bemcgarvey/RX12G/README.md

## RX12G  

Next generation of the RX12 receiver with built in gyro/stabilization  
Can be used with up to 3 DSMX satellite receivers or with any receiver that supports sBus output
(like the FrSky XSR or r-XSR receivers)  

Documentation will appear here once I complete it.
