bemcgarvey/RX12G/software/RX12GConfig/images/Gauge.png

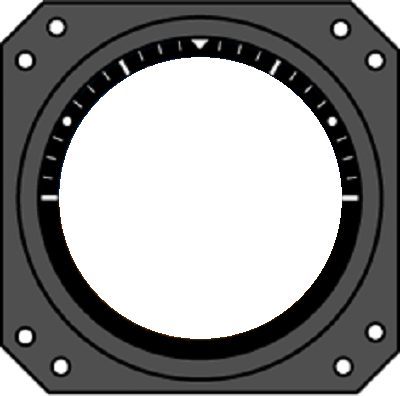
software/RX12GConfig/images/Gauge.png
