bemcgarvey/RX12G/schematic/RX12G.xlsx

RX12G BOM
Item | Qty | Reference(s) | Value | Footprint
1 | 9 | C1, C2, C3, C4, C5, C6, C7, C10, C11 | 100 nF | Capacitor_SMD:C_0402_1005Metric
2 | 1 | C8 | 10 uF | Capacitor_SMD:C_0603_1608Metric
3 | 1 | C9 | 2.2 uF | Capacitor_SMD:C_0603_1608Metric
4 | 5 | D1, D2, D3, D4, D6 | LED | LED_SMD:LED_0603_1608Metric
5 | 1 | D5 | MBR0520LT | Diode_SMD:D_SOD-123
6 | 1 | J1 | ICSP | Connector_PinHeader_2.54mm:PinHeader_1x05_P2.54mm_Vertical
7 | 3 | J2, J3, J4 | TSW-104-08-G-T-RA | SamacSys Parts:HDRRA12W64P254_3X4_1016X254X810P
8 | 3 | J5, J6, J8 | Conn_01x03 | JST_New:JST_ZH_B3B-ZR_1x03_P1.50mm_Vertical
9 | 1 | J7 | USB_B_Micro | Connector_USB:USB_Micro-B_Amphenol_10118194_Horizontal
10 | 1 | Q1 | 2N7002P_215 | digikey:SOT-23-3
11 | 4 | R1, R8, R10, R11 | 10k | Resistor_SMD:R_0603_1608Metric
12 | 4 | R2, R4, R5, R12 | 220R | Resistor_SMD:R_0603_1608Metric
13 | 1 | R3 | 62R | Resistor_SMD:R_0603_1608Metric
14 | 1 | R6 | 100k | Resistor_SMD:R_0603_1608Metric
15 | 1 | R7 | 1k | Resistor_SMD:R_0603_1608Metric
16 | 1 | R9 | 20k | Resistor_SMD:R_0603_1608Metric
17 | 1 | SW1 | SW_MEC_5E | SamacSys Parts:PTS647SK38SMTR2LFS
18 | 1 | U1 | PIC32MK1024GPK064-I/PT | PIC32MK:PIC32MK1024GPK064-I&slash_PT
19 | 1 | U2 | LSM6DSO32TR | IMU:LSM6DSO32TR
20 | 1 | U3 | AP2210N-3.3TRG1 | SamacSys Parts:SOT95P280X145-3N
21 | 1 | X1 | 24 MHz | SamacSys Parts:ASTMUPCE3312000MHZLJET
