bemcgarvey/RX12G/docs/ChangeLog.txt

RX12G Change log

Firmware:
	V1.0	Initial release
	V1.1	Fixed a bug in the bind routine
	V1.2	Added ExpressLRS (CRSF) receiver option
	
Software:
	V1.0	Initial release
	V1.2	Updated for ExpressLRS option (also changed to match firmware version.)
	
PCB:
	V1.0	Initial release
