bemcgarvey/RX12G/schematic/RX12G.kicad_pcb

## KiCad design schematic/RX12G.kicad_pcb (2025-07-03)

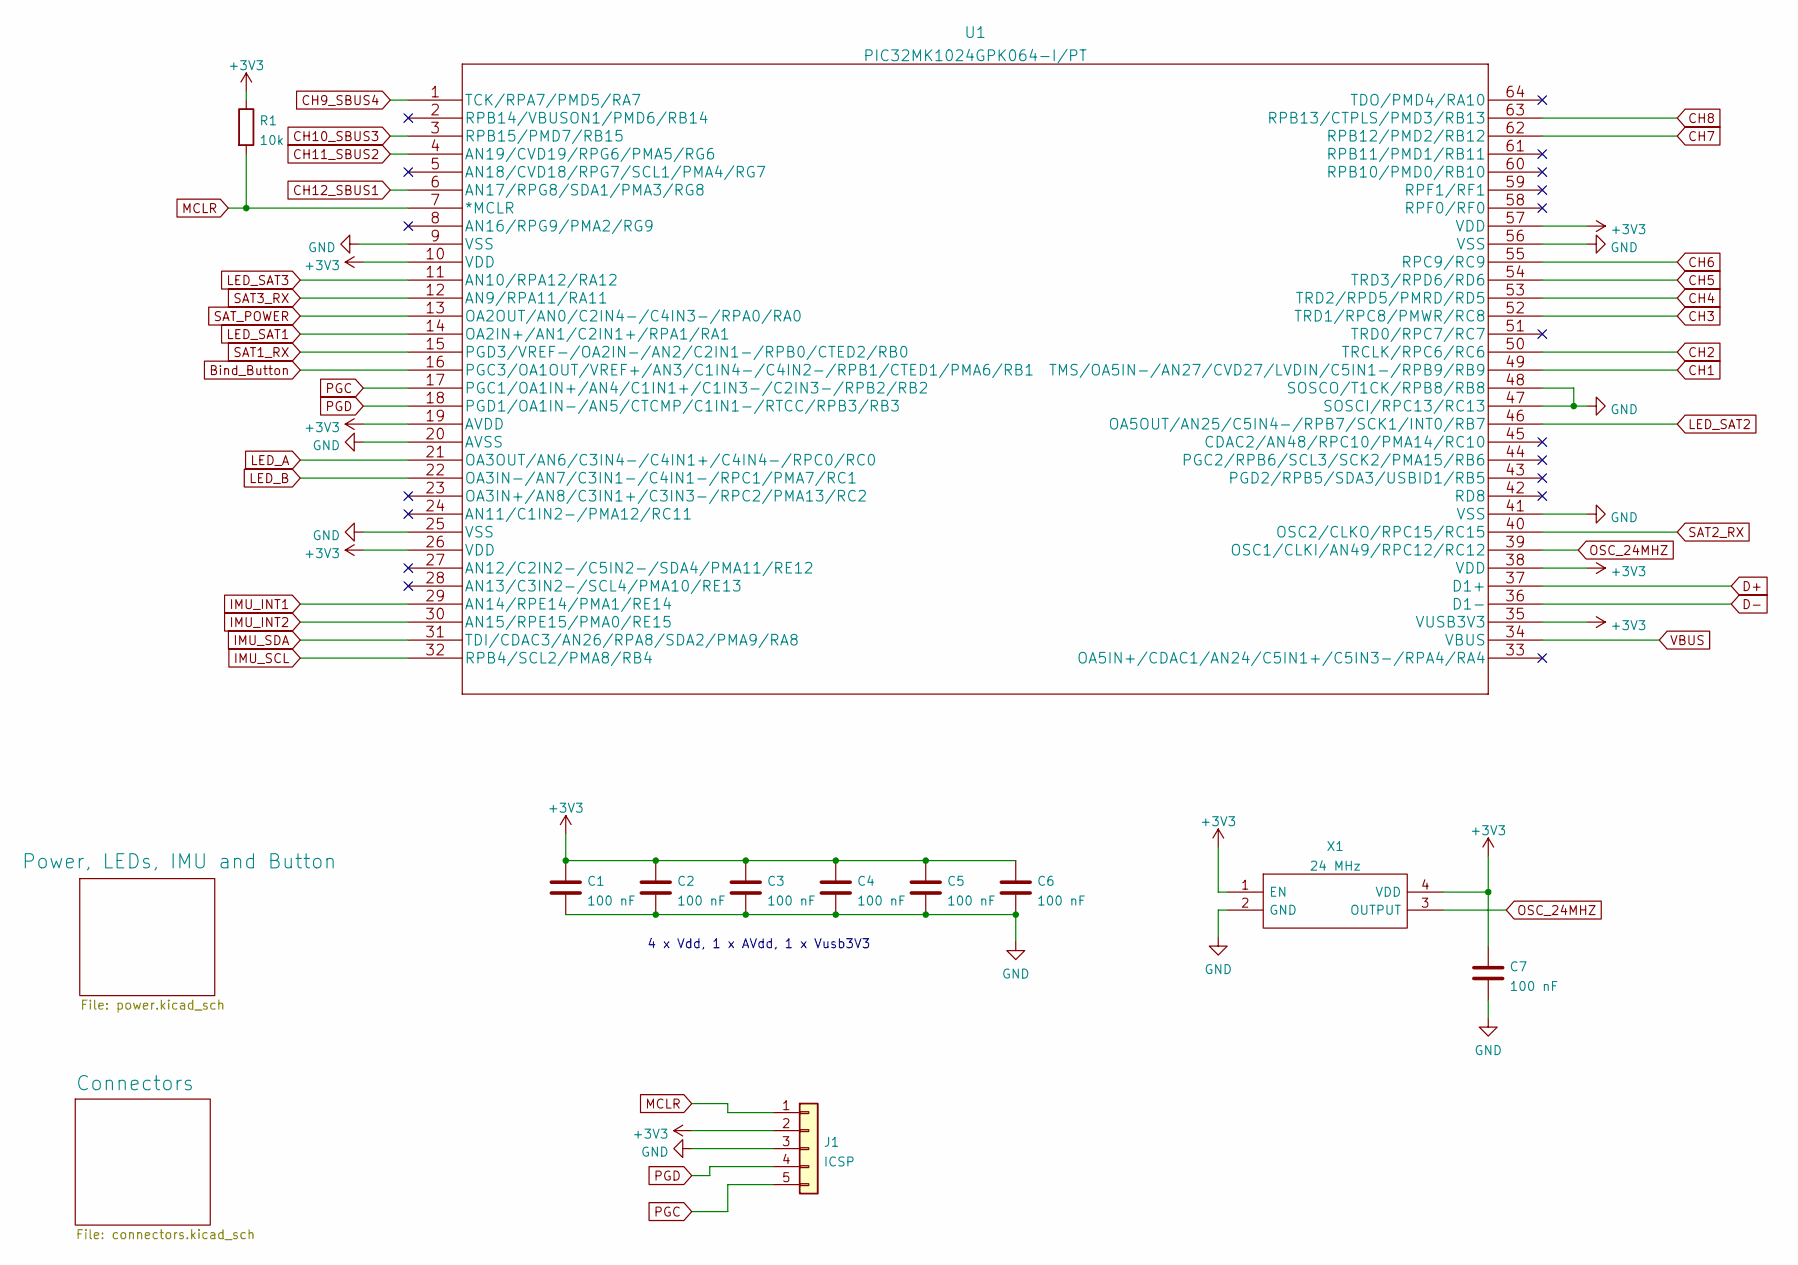
[picture p2: schematic RX12G.kicad_sch]

Parts:
C1, C2, C3, C4, C5, C6, C7: 100 nF; C_0402_1005Metric
J1: ICSP; PinHeader_1x05_P2.54mm_Vertical
R1: 10k; R_0603_1608Metric
U1: PIC32MK1024GPK064-I/PT; PIC32MK1024GPK064-I&slash_PT
X1: 24 MHz; ASTMUPCE3312000MHZLJET; Mouser Part Number 815-AMPMAFB-12.0000T

Connections:
+3V3: C1.1, C2.1, C3.1, C4.1, C5.1, C6.1, C7.1, J1.2, R1.1, U1.10 (VDD), U1.19 (AVDD), U1.26 (VDD), U1.35 (VUSB3V3), U1.38 (VDD), U1.57 (VDD), X1.1 (EN), X1.4 (VDD); also elsewhere on the board
Bind_Button: U1.16 (PGC3/OA1OUT/VREF+/AN3/C1IN4-/C4IN2-/RPB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); also elsewhere on the board
CH1: U1.49 (TMS/OA5IN-/AN27/CVD27/LVDIN/C5IN1-/RPB9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); also elsewhere on the board
CH2: U1.50 (TRCLK/RPC6/RC6); also elsewhere on the board
CH3: U1.52 (TRD1/RPC8/PMWR/RC8); also elsewhere on the board
CH4: U1.53 (TRD2/RPD5/PMRD/RD5); also elsewhere on the board
CH5: U1.54 (TRD3/RPD6/RD6); also elsewhere on the board
CH6: U1.55 (RPC9/RC9); also elsewhere on the board
CH7: U1.62 (RPB12/PMD2/RB12); also elsewhere on the board
CH8: U1.63 (RPB13/CTPLS/PMD3/RB13); also elsewhere on the board
CH9_SBUS4: U1.1 (TCK/RPA7/PMD5/RA7); also elsewhere on the board
CH10_SBUS3: U1.3 (RPB15/PMD7/RB15); also elsewhere on the board
CH11_SBUS2: U1.4 (AN19/CVD19/RPG6/PMA5/RG6); also elsewhere on the board
CH12_SBUS1: U1.6 (AN17/RPG8/SDA1/PMA3/RG8); also elsewhere on the board
D+: U1.37 (D1+); also elsewhere on the board
D-: U1.36 (D1-); also elsewhere on the board
GND: C1.2, C2.2, C3.2, C4.2, C5.2, C6.2, C7.2, J1.3, U1.9 (VSS), U1.20 (AVSS), U1.25 (VSS), U1.41 (VSS), U1.47 (SOSCI/RPC13/RC13), U1.48 (SOSCO/T1CK/RPB8/RB8), U1.56 (VSS), X1.2 (GND); also elsewhere on the board
IMU_INT1: U1.29 (AN14/RPE14/PMA1/RE14); also elsewhere on the board
IMU_INT2: U1.30 (AN15/RPE15/PMA0/RE15); also elsewhere on the board
IMU_SCL: U1.32 (RPB4/SCL2/PMA8/RB4); also elsewhere on the board
IMU_SDA: U1.31 (TDI/CDAC3/AN26/RPA8/SDA2/PMA9/RA8); also elsewhere on the board
LED_A: U1.21 (OA3OUT/AN6/C3IN4-/C4IN1+/C4IN4-/RPC0/RC0); also elsewhere on the board
LED_B: U1.22 (OA3IN-/AN7/C3IN1-/C4IN1-/RPC1/PMA7/RC1); also elsewhere on the board
LED_SAT1: U1.14 (OA2IN+/AN1/C2IN1+/RPA1/RA1); also elsewhere on the board
LED_SAT2: U1.46 (OA5OUT/AN25/C5IN4-/RPB7/SCK1/INT0/RB7); also elsewhere on the board
LED_SAT3: U1.11 (AN10/RPA12/RA12); also elsewhere on the board
MCLR: J1.1, R1.2, U1.7 (*MCLR)
OSC_24MHZ: U1.39 (OSC1/CLKI/AN49/RPC12/RC12), X1.3 (OUTPUT)
PGC: J1.5, U1.17 (PGC1/OA1IN+/AN4/C1IN1+/C1IN3-/C2IN3-/RP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)
PGD: J1.4, U1.18 (PGD1/OA1IN-/AN5/CTCMP/C1IN1-/RTCC/RPB3/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)
SAT1_RX: U1.15 (PGD3/VREF-/OA2IN-/AN2/C2IN1-/RPB0/CTED2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); also elsewhere on the board
SAT2_RX: U1.40 (OSC2/CLKO/RPC15/RC15); also elsewhere on the board
SAT3_RX: U1.12 (AN9/RPA11/RA11); also elsewhere on the board
SAT_POWER: U1.13 (OA2OUT/AN0/C2IN4-/C4IN3-/RPA0/RA0); also elsewhere on the board
VBUS: U1.34 (VBUS); also elsewhere on the board

Notes on the sheet:
4 x Vdd, 1 x AVdd, 1 x Vusb3V3

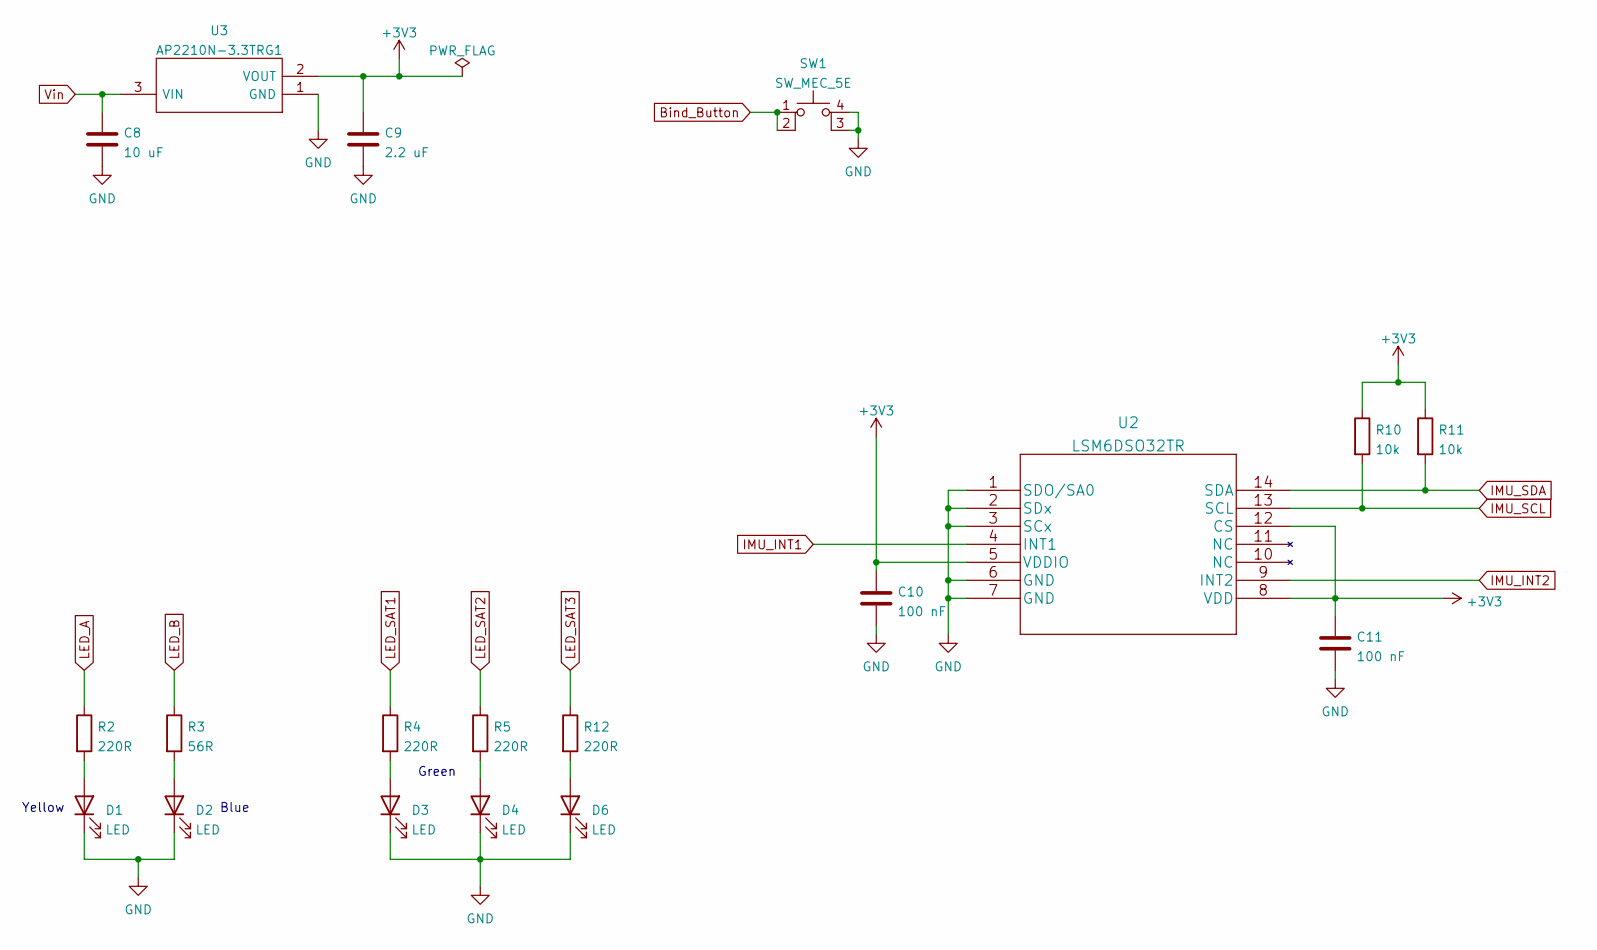
[picture p3: schematic power.kicad_sch, RX12G]

Parts:
C8: 10 uF; C_0603_1608Metric
C9: 2.2 uF; C_0603_1608Metric
C10, C11: 100 nF; C_0402_1005Metric
D1, D2, D3, D4, D6: LED; LED_0603_1608Metric
R2, R4, R5, R12: 220R; R_0603_1608Metric
R3: 56R; R_0603_1608Metric
R10, R11: 10k; R_0603_1608Metric
SW1: SW_MEC_5E; PTS647SK38SMTR2LFS
U2: LSM6DSO32TR
U3: AP2210N-3.3TRG1; SOT95P280X145-3N; Mouser Part Number 621-AP2210N-3.3TRG1

Connections:
+3V3: C9.1, C10.1, C11.1, R10.1, R11.1, U2.5 (VDDIO), U2.8 (VDD), U2.12 (CS), U3.2 (VOUT); also elsewhere on the board
Bind_Button: SW1.1, SW1.2; also elsewhere on the board
GND: C8.2, C9.2, C10.2, C11.2, D1.1 (K), D2.1 (K), D3.1 (K), D4.1 (K), D6.1 (K), SW1.3 (K), SW1.4 (A), U2.1 (SDO/SA0), U2.2 (SDx), U2.3 (SCx), U2.6 (GND), U2.7 (GND), U3.1 (GND); also elsewhere on the board
IMU_INT1: U2.4 (INT1); also elsewhere on the board
IMU_INT2: U2.9 (INT2); also elsewhere on the board
IMU_SCL: R10.2, U2.13 (SCL); also elsewhere on the board
IMU_SDA: R11.2, U2.14 (SDA); also elsewhere on the board
LED_A: R2.1; also elsewhere on the board
LED_B: R3.1; also elsewhere on the board
LED_SAT1: R4.1; also elsewhere on the board
LED_SAT2: R5.1; also elsewhere on the board
LED_SAT3: R12.1; also elsewhere on the board
unnamed: D1.2 (A), R2.2
unnamed: D2.2 (A), R3.2
unnamed: D3.2 (A), R4.2
unnamed: D4.2 (A), R5.2
unnamed: D6.2 (A), R12.2
Vin: C8.1, U3.3 (VIN); also elsewhere on the board

Notes on the sheet:
Blue
Yellow
Green

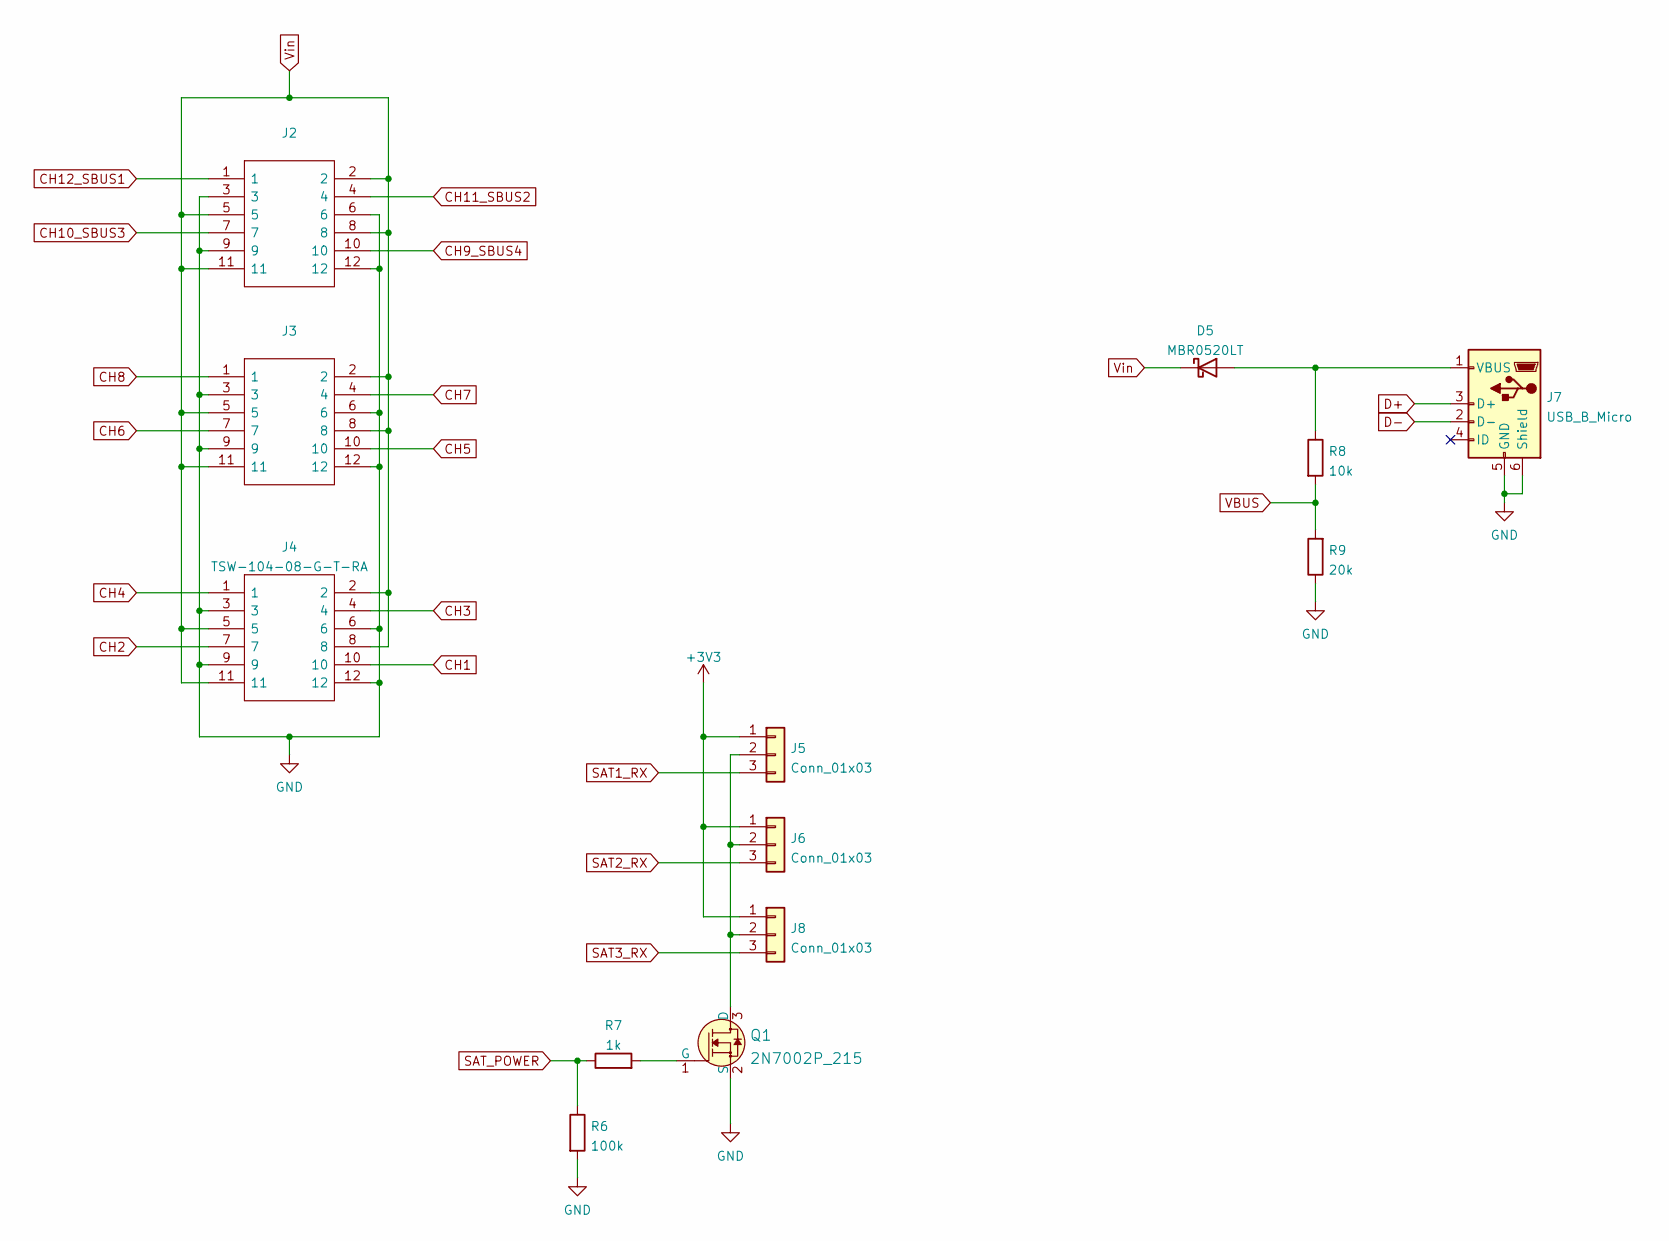
[picture p4: schematic connectors.kicad_sch, RX12G]

Parts:
D5: MBR0520LT; D_SOD-123
J2, J3, J4: TSW-104-08-G-T-RA; HDRRA12W64P254_3X4_1016X254X810P; Mouser Part Number 200-TSW10408GTRA
J5, J6, J8: Conn_01x03; JST_ZH_B3B-ZR_1x03_P1.50mm_Vertical
J7: USB_B_Micro; USB_Micro-B_Amphenol_10118194_Horizontal
Q1: 2N7002P_215; SOT-23-3; MPN 2N7002P,215; Digi-Key_PN 1727-4692-1-ND
R6: 100k; R_0603_1608Metric
R7: 1k; R_0603_1608Metric
R8: 10k; R_0603_1608Metric
R9: 20k; R_0603_1608Metric

Connections:
+3V3: J5.1, J6.1, J8.1; also elsewhere on the board
CH1: J4.10; also elsewhere on the board
CH2: J4.7; also elsewhere on the board
CH3: J4.4; also elsewhere on the board
CH4: J4.1; also elsewhere on the board
CH5: J3.10; also elsewhere on the board
CH6: J3.7; also elsewhere on the board
CH7: J3.4; also elsewhere on the board
CH8: J3.1; also elsewhere on the board
CH9_SBUS4: J2.10; also elsewhere on the board
CH10_SBUS3: J2.7; also elsewhere on the board
CH11_SBUS2: J2.4; also elsewhere on the board
CH12_SBUS1: J2.1; also elsewhere on the board
D+: J7.3 (D+); also elsewhere on the board
D-: J7.2 (D-); also elsewhere on the board
GND: J2.3, J2.6, J2.9, J2.12, J3.3, J3.6, J3.9, J3.12, J4.3, J4.6, J4.9, J4.12, J7.5 (GND), J7.6 (Shield), Q1.2 (S), R6.2, R9.1; also elsewhere on the board
unnamed: D5.2 (A), J7.1 (VBUS), R8.1
unnamed: J5.2, J6.2, J8.2, Q1.3 (D)
unnamed: Q1.1 (G), R7.2
SAT1_RX: J5.3; also elsewhere on the board
SAT2_RX: J6.3; also elsewhere on the board
SAT3_RX: J8.3; also elsewhere on the board
SAT_POWER: R6.1, R7.1; also elsewhere on the board
VBUS: R8.2, R9.2; also elsewhere on the board
Vin: D5.1 (K), J2.2, J2.5, J2.8, J2.11, J3.2, J3.5, J3.8, J3.11, J4.2, J4.5, J4.8, J4.11; also elsewhere on the board

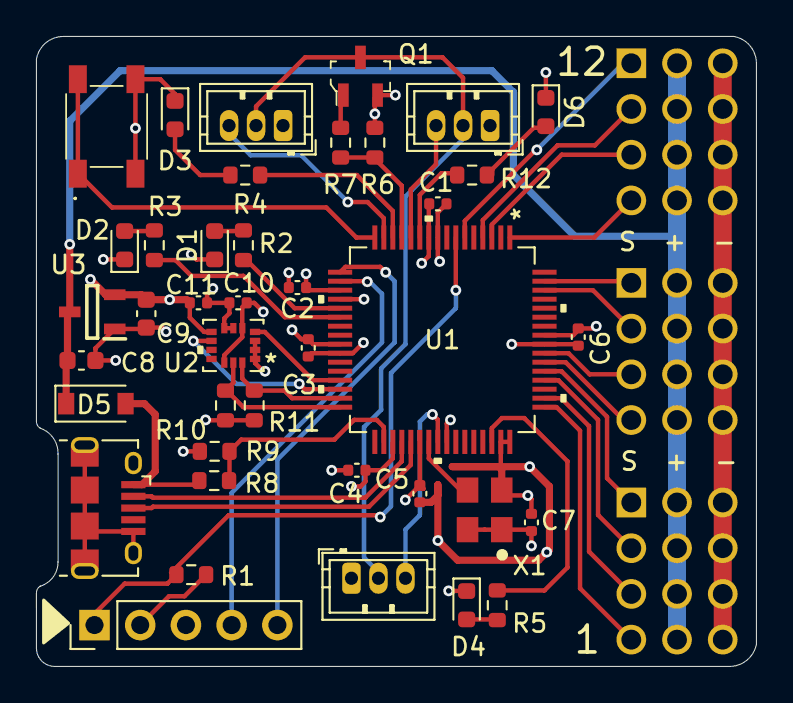
[picture p5: board RX12G.kicad_pcb from above]

Board: 4 copper layers, 40.0 x 35.0 mm, 43 parts (0 on the bottom side), 44 nets.
