bemcgarvey/RX12G/firmware/src/config/default/default.mhc/project.yml

files:
- generatedChecksum: F58DB2348A0FCE945652B285010E5F8A
  logicalPath: FreeRTOS/Source
  name: FreeRTOS_tasks.c
  physicalPath: ../../third_party/rtos/FreeRTOS/Source
  security: NON_SECURE
  type: SOURCE
  userChecksum: F58DB2348A0FCE945652B285010E5F8A
- generatedChecksum: 8ACE0DEBD82F6829438A4674565451FB
  logicalPath: FreeRTOS/Source
  name: croutine.c
  physicalPath: ../../third_party/rtos/FreeRTOS/Source
  security: NON_SECURE
  type: SOURCE
  userChecksum: 8ACE0DEBD82F6829438A4674565451FB
- generatedChecksum: DC797D8719875948452BA69E3CA29A20
  logicalPath: config/default/driver/usb/usbfs/src
  name: drv_usbfs.c
  physicalPath: driver/usb/usbfs/src
  security: NON_SECURE
  type: SOURCE
  userChecksum: DC797D8719875948452BA69E3CA29A20
- generatedChecksum: 77A61E825804B2CA96FC95734161DDE6
  logicalPath: config/default/driver/usb/usbfs/src
  name: drv_usbfs_device.c
  physicalPath: driver/usb/usbfs/src
  security: NON_SECURE
  type: SOURCE
  userChecksum: 77A61E825804B2CA96FC95734161DDE6
- generatedChecksum: B3B5445B14BD9B6A35F1C5B995C9BBF7
  logicalPath: FreeRTOS/Source
  name: event_groups.c
  physicalPath: ../../third_party/rtos/FreeRTOS/Source
  security: NON_SECURE
  type: SOURCE
  userChecksum: B3B5445B14BD9B6A35F1C5B995C9BBF7
- generatedChecksum: 4BBDE3B7B0DAEE2CA5A8F519001D5BFF
  logicalPath: config/default
  name: exceptions.c
  physicalPath: ''
  security: NON_SECURE
  type: SOURCE
  userChecksum: 4BBDE3B7B0DAEE2CA5A8F519001D5BFF
- generatedChecksum: B7DBFD6F500AAD4713403E985EB18EAE
  logicalPath: config/default
  name: freertos_hooks.c
  physicalPath: ''
  security: NON_SECURE
  type: SOURCE
  userChecksum: B7DBFD6F500AAD4713403E985EB18EAE
- generatedChecksum: 972E955D94A63BA89BF6ABD6AADB1023
  logicalPath: FreeRTOS/Source/portable/MemMang
  name: heap_1.c
  physicalPath: ../../third_party/rtos/FreeRTOS/Source/portable/MemMang
  security: NON_SECURE
  type: SOURCE
  userChecksum: 972E955D94A63BA89BF6ABD6AADB1023
- generatedChecksum: 48812D34B3555F392EFF538B2A6A2353
  logicalPath: config/default
  name: initialization.c
  physicalPath: ''
  security: NON_SECURE
  type: SOURCE
  userChecksum: 3A6EB55353075EAA23272D4A66DB0A16
- generatedChecksum: 384AE8E9396E7FE9A9E65B6F2B428288
  logicalPath: config/default
  name: interrupts.c
  physicalPath: ''
  security: NON_SECURE
  type: SOURCE
  userChecksum: 539F881B37D143FDCCB9A4367FEBEFB9
- generatedChecksum: 70F7AD626138E8BD00ED013EAD14C618
  logicalPath: config/default
  name: interrupts_a.S
  physicalPath: ''
  security: NON_SECURE
  type: SOURCE
  userChecksum: 70F7AD626138E8BD00ED013EAD14C618
- generatedChecksum: 3FEE521CEF14928AE38E7FA9BF6D75E6
  logicalPath: FreeRTOS/Source
  name: list.c
  physicalPath: ../../third_party/rtos/FreeRTOS/Source
  security: NON_SECURE
  type: SOURCE
  userChecksum: 3FEE521CEF14928AE38E7FA9BF6D75E6
- generatedChecksum: null
  logicalPath: ''
  name: main.c
  physicalPath: ../..
  security: NON_SECURE
  type: SOURCE
  userChecksum: null
- generatedChecksum: 8FDD6248506F28B32C4F5FD9AA0D9C6F
  logicalPath: config/default/osal
  name: osal_freertos.c
  physicalPath: osal
  security: NON_SECURE
  type: SOURCE
  userChecksum: 8FDD6248506F28B32C4F5FD9AA0D9C6F
- generatedChecksum: F5E41C2993989490F38B123FA11C9263
  logicalPath: config/default/peripheral/clk
  name: plib_clk.c
  physicalPath: peripheral/clk
  security: NON_SECURE
  type: SOURCE
  userChecksum: B8C42457976288F32E9F4C2873EB2320
- generatedChecksum: F8BB2BAA74068083A80E6E229BBCF3E3
  logicalPath: config/default/peripheral/coretimer
  name: plib_coretimer.c
  physicalPath: peripheral/coretimer
  security: NON_SECURE
  type: SOURCE
  userChecksum: F8BB2BAA74068083A80E6E229BBCF3E3
- generatedChecksum: 5BFD7C5599A1B32A969F2C09F13311BC
  logicalPath: config/default/peripheral/dmac
  name: plib_dmac.c
  physicalPath: peripheral/dmac
  security: NON_SECURE
  type: SOURCE
  userChecksum: 5BFD7C5599A1B32A969F2C09F13311BC
- generatedChecksum: F0F77E9605002F86303776FD504751EB
  logicalPath: config/default/peripheral/eeprom
  name: plib_eeprom.c
  physicalPath: peripheral/eeprom
  security: NON_SECURE
  type: SOURCE
  userChecksum: F0F77E9605002F86303776FD504751EB
- generatedChecksum: 086ECC21CDD1F409510ABE62F9ED852D
  logicalPath: config/default/peripheral/evic
  name: plib_evic.c
  physicalPath: peripheral/evic
  security: NON_SECURE
  type: SOURCE
  userChecksum: 086ECC21CDD1F409510ABE62F9ED852D
- generatedChecksum: 164C9CF0E8E5FC6CB108971E897BB18D
  logicalPath: config/default/peripheral/gpio
  name: plib_gpio.c
  physicalPath: peripheral/gpio
  security: NON_SECURE
  type: SOURCE
  userChecksum: 164C9CF0E8E5FC6CB108971E897BB18D
- generatedChecksum: 099E9B7B3808BD6A9ED5E3D0246DEDAD
  logicalPath: config/default/peripheral/i2c/master
  name: plib_i2c2_master.c
  physicalPath: peripheral/i2c/master
  security: NON_SECURE
  type: SOURCE
  userChecksum: 099E9B7B3808BD6A9ED5E3D0246DEDAD
- generatedChecksum: B5141F23FAB135F92A71071EEBDC3ED2
  logicalPath: config/default/peripheral/tmr
  name: plib_tmr2.c
  physicalPath: peripheral/tmr
  security: NON_SECURE
  type: SOURCE
  userChecksum: B5141F23FAB135F92A71071EEBDC3ED2
- generatedChecksum: 96370224FB0E16D2836D4CE9CF8AEFF5
  logicalPath: config/default/peripheral/tmr
  name: plib_tmr5.c
  physicalPath: peripheral/tmr
  security: NON_SECURE
  type: SOURCE
  userChecksum: 96370224FB0E16D2836D4CE9CF8AEFF5
- generatedChecksum: F503211688B80701FFC8E8C8F6A49DFC
  logicalPath: config/default/peripheral/tmr
  name: plib_tmr6.c
  physicalPath: peripheral/tmr
  security: NON_SECURE
  type: SOURCE
  userChecksum: F503211688B80701FFC8E8C8F6A49DFC
- generatedChecksum: B9579201B0CE4CA37E49E2B0B27DEAEF
  logicalPath: config/default/peripheral/tmr
  name: plib_tmr7.c
  physicalPath: peripheral/tmr
  security: NON_SECURE
  type: SOURCE
  userChecksum: B9579201B0CE4CA37E49E2B0B27DEAEF
- generatedChecksum: 057EEB6ABFE129F06B5EE43255777501
  logicalPath: config/default/peripheral/tmr
  name: plib_tmr8.c
  physicalPath: peripheral/tmr
  security: NON_SECURE
  type: SOURCE
  userChecksum: 057EEB6ABFE129F06B5EE43255777501
- generatedChecksum: 7B8D2E0DA556712DBC3DF51B76A57427
  logicalPath: config/default/peripheral/tmr
  name: plib_tmr9.c
  physicalPath: peripheral/tmr
  security: NON_SECURE
  type: SOURCE
  userChecksum: 7B8D2E0DA556712DBC3DF51B76A57427
- generatedChecksum: 3822D4C43CB11882404ECB2B28DD61EA
  logicalPath: config/default/driver/usb/usbfs/src
  name: plib_usbfs_header.h
  physicalPath: driver/usb/usbfs/src
  security: NON_SECURE
  type: SOURCE
  userChecksum: 3822D4C43CB11882404ECB2B28DD61EA
- generatedChecksum: D2B5BDC2F4578FDBBADED01931AF6259
  logicalPath: config/default/peripheral/wdt
  name: plib_wdt.c
  physicalPath: peripheral/wdt
  security: NON_SECURE
  type: SOURCE
  userChecksum: D2B5BDC2F4578FDBBADED01931AF6259
- generatedChecksum: 0E851159CFF7B40028D295108F0F7474
  logicalPath: FreeRTOS/Source/portable/MPLAB/PIC32MK
  name: port.c
  physicalPath: ../../third_party/rtos/FreeRTOS/Source/portable/MPLAB/PIC32MK
  security: NON_SECURE
  type: SOURCE
  userChecksum: 0E851159CFF7B40028D295108F0F7474
- generatedChecksum: 17FB1DE2D7DF3950AACC03B19F54459C
  logicalPath: FreeRTOS/Source/portable/MPLAB/PIC32MK
  name: port_asm.S
  physicalPath: ../../third_party/rtos/FreeRTOS/Source/portable/MPLAB/PIC32MK
  security: NON_SECURE
  type: SOURCE
  userChecksum: 17FB1DE2D7DF3950AACC03B19F54459C
- generatedChecksum: 09041728D74A4E3A32C7D4EAA96C4EE7
  logicalPath: FreeRTOS/Source
  name: queue.c
  physicalPath: ../../third_party/rtos/FreeRTOS/Source
  security: NON_SECURE
  type: SOURCE
  userChecksum: 09041728D74A4E3A32C7D4EAA96C4EE7
- generatedChecksum: D6CF30BDCE1A813D9ACF3905EBD6A871
  logicalPath: FreeRTOS/Source
  name: stream_buffer.c
  physicalPath: ../../third_party/rtos/FreeRTOS/Source
  security: NON_SECURE
  type: SOURCE
  userChecksum: D6CF30BDCE1A813D9ACF3905EBD6A871
- generatedChecksum: C95CE0ABB86E6B11CF77E8891D294510
  logicalPath: config/default/system/int
  name: sys_int.c
  physicalPath: system/int/src
  security: NON_SECURE
  type: SOURCE
  userChecksum: C95CE0ABB86E6B11CF77E8891D294510
- generatedChecksum: 47B584985982B2FF32628D4CB874CB4D
  logicalPath: config/default/system/reset
  name: sys_reset.c
  physicalPath: system/reset
  security: NON_SECURE
  type: SOURCE
  userChecksum: 47B584985982B2FF32628D4CB874CB4D
- generatedChecksum: 9A24475E3F58E7FE0B22FBA7B0A412A3
  logicalPath: config/default
  name: tasks.c
  physicalPath: ''
  security: NON_SECURE
  type: SOURCE
  userChecksum: 9A24475E3F58E7FE0B22FBA7B0A412A3
- generatedChecksum: F1B86F6E1527FD59A8713B67564F2898
  logicalPath: FreeRTOS/Source
  name: timers.c
  physicalPath: ../../third_party/rtos/FreeRTOS/Source
  security: NON_SECURE
  type: SOURCE
  userChecksum: F1B86F6E1527FD59A8713B67564F2898
- generatedChecksum: BCCEF5B801FFD0CF22D0B454D2F25F1F
  logicalPath: config/default/usb/src
  name: usb_device.c
  physicalPath: usb/src
  security: NON_SECURE
  type: SOURCE
  userChecksum: BCCEF5B801FFD0CF22D0B454D2F25F1F
- generatedChecksum: B8D87B6533E2CE239E9EEB8486DF6996
  logicalPath: config/default/usb/src
  name: usb_device_hid.c
  physicalPath: usb/src
  security: NON_SECURE
  type: SOURCE
  userChecksum: B8D87B6533E2CE239E9EEB8486DF6996
- generatedChecksum: C8B9A085F9A89EDFB3EC7EF9DF31BFC5
  logicalPath: config/default
  name: usb_device_init_data_0.c
  physicalPath: ''
  security: NON_SECURE
  type: SOURCE
  userChecksum: C8B9A085F9A89EDFB3EC7EF9DF31BFC5
- generatedChecksum: AF3A8D8AA610E7DFD3E38DDAC5E42074
  logicalPath: FreeRTOS/Source/include
  name: FreeRTOS.h
  physicalPath: ../../third_party/rtos/FreeRTOS/Source/include
  security: NON_SECURE
  type: HEADER
  userChecksum: AF3A8D8AA610E7DFD3E38DDAC5E42074
- generatedChecksum: 7E278F4639C6DDA26AC68183CFDAFB91
  logicalPath: config/default
  name: FreeRTOSConfig.h
  physicalPath: ''
  security: NON_SECURE
  type: HEADER
  userChecksum: 7E278F4639C6DDA26AC68183CFDAFB91
- generatedChecksum: 774011E09B9B257B4F572704E6AB9713
  logicalPath: FreeRTOS/Source/portable/MPLAB/PIC32MK
  name: ISR_Support.h
  physicalPath: ../../third_party/rtos/FreeRTOS/Source/portable/MPLAB/PIC32MK
  security: NON_SECURE
  type: HEADER
  userChecksum: 774011E09B9B257B4F572704E6AB9713
- generatedChecksum: A04D7EA37253EF8D3ED03A4EF0637642
  logicalPath: config/default
  name: configuration.h
  physicalPath: ''
  security: NON_SECURE
  type: HEADER
  userChecksum: A04D7EA37253EF8D3ED03A4EF0637642
- generatedChecksum: 48B661D8C967C6BC397001F10FB43D1D
  logicalPath: FreeRTOS/Source/include
  name: croutine.h
  physicalPath: ../../third_party/rtos/FreeRTOS/Source/include
  security: NON_SECURE
  type: HEADER
  userChecksum: 48B661D8C967C6BC397001F10FB43D1D
- generatedChecksum: B33906420624CD537F3925E83091D2BF
  logicalPath: config/default
  name: definitions.h
  physicalPath: ''
  security: NON_SECURE
  type: HEADER
  userChecksum: B33906420624CD537F3925E83091D2BF
- generatedChecksum: 1EA4EDD5EA90F43EC407DE32441159A9
  logicalPath: FreeRTOS/Source/include
  name: deprecated_definitions.h
  physicalPath: ../../third_party/rtos/FreeRTOS/Source/include
  security: NON_SECURE
  type: HEADER
  userChecksum: 1EA4EDD5EA90F43EC407DE32441159A9
- generatedChecksum: E189C26B2269F8DE46033CCD0621958D
  logicalPath: config/default
  name: device.h
  physicalPath: ''
  security: NON_SECURE
  type: HEADER
  userChecksum: E189C26B2269F8DE46033CCD0621958D
- generatedChecksum: 1D2094DFA60F847FFD4E8153B6E78027
  logicalPath: config/default/driver
  name: driver.h
  physicalPath: driver
  security: NON_SECURE
  type: HEADER
  userChecksum: 1D2094DFA60F847FFD4E8153B6E78027
- generatedChecksum: CC7DFCC51CD25171A3E400E18969354F
  logicalPath: config/default/driver
  name: driver_common.h
  physicalPath: driver
  security: NON_SECURE
  type: HEADER
  userChecksum: CC7DFCC51CD25171A3E400E18969354F
- generatedChecksum: DF147276AE56CA76E3E9BEB8447620AB
  logicalPath: config/default/driver/usb
  name: drv_usb.h
  physicalPath: driver/usb
  security: NON_SECURE
  type: HEADER
  userChecksum: DF147276AE56CA76E3E9BEB8447620AB
- generatedChecksum: A8072403A5346EF85CDFD4EF996C0826
  logicalPath: config/default/driver/usb
  name: drv_usb_external_dependencies.h
  physicalPath: driver/usb
  security: NON_SECURE
  type: HEADER
  userChecksum: A8072403A5346EF85CDFD4EF996C0826
- generatedChecksum: 8E09A88EA42C831AF5D8F17A1549E1D2
  logicalPath: config/default/driver/usb/usbfs
  name: drv_usbfs.h
  physicalPath: driver/usb/usbfs
  security: NON_SECURE
  type: HEADER
  userChecksum: 8E09A88EA42C831AF5D8F17A1549E1D2
- generatedChecksum: BA88E5162CA794A6A62D146A58458A43
  logicalPath: config/default/driver/usb/usbfs/src
  name: drv_usbfs_local.h
  physicalPath: driver/usb/usbfs/src
  security: NON_SECURE
  type: HEADER
  userChecksum: BA88E5162CA794A6A62D146A58458A43
- generatedChecksum: AE86F1881720D058DAAAB3C5A196BC27
  logicalPath: config/default/driver/usb/usbfs/src
  name: drv_usbfs_variant_mapping.h
  physicalPath: driver/usb/usbfs/src
  security: NON_SECURE
  type: HEADER
  userChecksum: AE86F1881720D058DAAAB3C5A196BC27
- generatedChecksum: B1D1D455E111FA70C46AD40562D78CE2
  logicalPath: FreeRTOS/Source/include
  name: event_groups.h
  physicalPath: ../../third_party/rtos/FreeRTOS/Source/include
  security: NON_SECURE
  type: HEADER
  userChecksum: B1D1D455E111FA70C46AD40562D78CE2
- generatedChecksum: 4CF4A86296482D5331331BA301C20BB2
  logicalPath: config/default
  name: interrupts.h
  physicalPath: ''
  security: NON_SECURE
  type: HEADER
  userChecksum: 4CF4A86296482D5331331BA301C20BB2
- generatedChecksum: FE17D325A06479D956285C5438994B83
  logicalPath: FreeRTOS/Source/include
  name: list.h
  physicalPath: ../../third_party/rtos/FreeRTOS/Source/include
  security: NON_SECURE
  type: HEADER
  userChecksum: FE17D325A06479D956285C5438994B83
- generatedChecksum: DDE2C9D46642D120A0202AC851E1A777
  logicalPath: FreeRTOS/Source/include
  name: message_buffer.h
  physicalPath: ../../third_party/rtos/FreeRTOS/Source/include
  security: NON_SECURE
  type: HEADER
  userChecksum: DDE2C9D46642D120A0202AC851E1A777
- generatedChecksum: 2D674B8B1FCF07504AF90FA5CE2F9A23
  logicalPath: FreeRTOS/Source/include
  name: mpu_prototypes.h
  physicalPath: ../../third_party/rtos/FreeRTOS/Source/include
  security: NON_SECURE
  type: HEADER
  userChecksum: 2D674B8B1FCF07504AF90FA5CE2F9A23
- generatedChecksum: 953D372D8F7991D4F86AD4ABD42AE4CE
  logicalPath: FreeRTOS/Source/include
  name: mpu_wrappers.h
  physicalPath: ../../third_party/rtos/FreeRTOS/Source/include
  security: NON_SECURE
  type: HEADER
  userChecksum: 953D372D8F7991D4F86AD4ABD42AE4CE
- generatedChecksum: F0AD88762263B7CB89B02AB4F5876059
  logicalPath: config/default/osal
  name: osal.h
  physicalPath: osal
  security: NON_SECURE
  type: HEADER
  userChecksum: F0AD88762263B7CB89B02AB4F5876059
- generatedChecksum: 167A43EFF8A31441EBF85AC77958A30B
  logicalPath: config/default/osal
  name: osal_definitions.h
  physicalPath: osal
  security: NON_SECURE
  type: HEADER
  userChecksum: 167A43EFF8A31441EBF85AC77958A30B
- generatedChecksum: 9D6F205ECFDB2028C5CF766B52B5B7B2
  logicalPath: config/default/osal
  name: osal_freertos.h
  physicalPath: osal
  security: NON_SECURE
  type: HEADER
  userChecksum: 9D6F205ECFDB2028C5CF766B52B5B7B2
- generatedChecksum: 7066CC390335CF75126E2A50C46E3BDD
  logicalPath: config/default/peripheral/clk
  name: plib_clk.h
  physicalPath: peripheral/clk
  security: NON_SECURE
  type: HEADER
  userChecksum: 7066CC390335CF75126E2A50C46E3BDD
- generatedChecksum: E117D25137D333D9E62C091362100BB0
  logicalPath: config/default/peripheral/coretimer
  name: plib_coretimer.h
  physicalPath: peripheral/coretimer
  security: NON_SECURE
  type: HEADER
  userChecksum: E117D25137D333D9E62C091362100BB0
- generatedChecksum: AC36F429D7162D7D1A68B9955ED194A3
  logicalPath: config/default/peripheral/dmac
  name: plib_dmac.h
  physicalPath: peripheral/dmac
  security: NON_SECURE
  type: HEADER
  userChecksum: AC36F429D7162D7D1A68B9955ED194A3
- generatedChecksum: B97B50D5217602B30A68AA8AA5D77BFB
  logicalPath: config/default/peripheral/eeprom
  name: plib_eeprom.h
  physicalPath: peripheral/eeprom
  security: NON_SECURE
  type: HEADER
  userChecksum: B97B50D5217602B30A68AA8AA5D77BFB
- generatedChecksum: 3F18F037CD1B5E4C6C777D6DB6F07042
  logicalPath: config/default/peripheral/evic
  name: plib_evic.h
  physicalPath: peripheral/evic
  security: NON_SECURE
  type: HEADER
  userChecksum: 3F18F037CD1B5E4C6C777D6DB6F07042
- generatedChecksum: 313008477D7BED621D6BDF58998F3DEF
  logicalPath: config/default/peripheral/gpio
  name: plib_gpio.h
  physicalPath: peripheral/gpio
  security: NON_SECURE
  type: HEADER
  userChecksum: 313008477D7BED621D6BDF58998F3DEF
- generatedChecksum: 092C94C5559AFFB03C3483EE129E0E91
  logicalPath: config/default/peripheral/i2c/master
  name: plib_i2c2_master.h
  physicalPath: peripheral/i2c/master
  security: NON_SECURE
  type: HEADER
  userChecksum: 092C94C5559AFFB03C3483EE129E0E91
- generatedChecksum: B963C6FE44292A1C4A14C3BA5BE95AEE
  logicalPath: config/default/peripheral/i2c/master
  name: plib_i2c_master_common.h
  physicalPath: peripheral/i2c/master
  security: NON_SECURE
  type: HEADER
  userChecksum: B963C6FE44292A1C4A14C3BA5BE95AEE
- generatedChecksum: 951CB6B720EFCD3044875413BC7D7773
  logicalPath: config/default/peripheral/tmr
  name: plib_tmr2.h
  physicalPath: peripheral/tmr
  security: NON_SECURE
  type: HEADER
  userChecksum: 951CB6B720EFCD3044875413BC7D7773
- generatedChecksum: 10F3D2095F245631617CC4D28D83A2C0
  logicalPath: config/default/peripheral/tmr
  name: plib_tmr5.h
  physicalPath: peripheral/tmr
  security: NON_SECURE
  type: HEADER
  userChecksum: 10F3D2095F245631617CC4D28D83A2C0
- generatedChecksum: CADC791B8E45B0CBF877D2802F32B46B
  logicalPath: config/default/peripheral/tmr
  name: plib_tmr6.h
  physicalPath: peripheral/tmr
  security: NON_SECURE
  type: HEADER
  userChecksum: CADC791B8E45B0CBF877D2802F32B46B
- generatedChecksum: 23E4AA7DD12CD3A643CCFB50062B6C31
  logicalPath: config/default/peripheral/tmr
  name: plib_tmr7.h
  physicalPath: peripheral/tmr
  security: NON_SECURE
  type: HEADER
  userChecksum: 23E4AA7DD12CD3A643CCFB50062B6C31
- generatedChecksum: 1F0B4D30975B35E9B52BEDF97E2C3574
  logicalPath: config/default/peripheral/tmr
  name: plib_tmr8.h
  physicalPath: peripheral/tmr
  security: NON_SECURE
  type: HEADER
  userChecksum: 1F0B4D30975B35E9B52BEDF97E2C3574
- generatedChecksum: 5A774A569BCE9577D105F98032AFAE70
  logicalPath: config/default/peripheral/tmr
  name: plib_tmr9.h
  physicalPath: peripheral/tmr
  security: NON_SECURE
  type: HEADER
  userChecksum: 5A774A569BCE9577D105F98032AFAE70
- generatedChecksum: D948F2CE092CAB556EF299D3CCD83A55
  logicalPath: config/default/peripheral/tmr
  name: plib_tmr_common.h
  physicalPath: peripheral/tmr
  security: NON_SECURE
  type: HEADER
  userChecksum: D948F2CE092CAB556EF299D3CCD83A55
- generatedChecksum: 7AFFC4178335897ED9D5804CAB531BCF
  logicalPath: config/default/driver/usb/usbfs/src
  name: plib_usbfs.h
  physicalPath: driver/usb/usbfs/src
  security: NON_SECURE
  type: HEADER
  userChecksum: 7AFFC4178335897ED9D5804CAB531BCF
- generatedChecksum: 52646F9F1734C5AA98A212549F6FE3E3
  logicalPath: config/default/peripheral/wdt
  name: plib_wdt.h
  physicalPath: peripheral/wdt
  security: NON_SECURE
  type: HEADER
  userChecksum: 52646F9F1734C5AA98A212549F6FE3E3
- generatedChecksum: 5A686FF678CBFBB4A1FEB86B66DCEC98
  logicalPath: FreeRTOS/Source/include
  name: portable.h
  physicalPath: ../../third_party/rtos/FreeRTOS/Source/include
  security: NON_SECURE
  type: HEADER
  userChecksum: 5A686FF678CBFBB4A1FEB86B66DCEC98
- generatedChecksum: 6E4E1E4FD0B92BD15236DAA237ABCCAB
  logicalPath: FreeRTOS/Source/portable/MPLAB/PIC32MK
  name: portmacro.h
  physicalPath: ../../third_party/rtos/FreeRTOS/Source/portable/MPLAB/PIC32MK
  security: NON_SECURE
  type: HEADER
  userChecksum: 6E4E1E4FD0B92BD15236DAA237ABCCAB
- generatedChecksum: 696F66B2428CC530389C53B5FE617CE1
  logicalPath: FreeRTOS/Source/include
  name: projdefs.h
  physicalPath: ../../third_party/rtos/FreeRTOS/Source/include
  security: NON_SECURE
  type: HEADER
  userChecksum: 696F66B2428CC530389C53B5FE617CE1
- generatedChecksum: 6CB1FF8C27E6755C63D75369D1D7A37A
  logicalPath: FreeRTOS/Source/include
  name: queue.h
  physicalPath: ../../third_party/rtos/FreeRTOS/Source/include
  security: NON_SECURE
  type: HEADER
  userChecksum: 6CB1FF8C27E6755C63D75369D1D7A37A
- generatedChecksum: 9F1AE7D29D09ED8CC21F3DA08049FB79
  logicalPath: FreeRTOS/Source/include
  name: semphr.h
  physicalPath: ../../third_party/rtos/FreeRTOS/Source/include
  security: NON_SECURE
  type: HEADER
  userChecksum: 9F1AE7D29D09ED8CC21F3DA08049FB79
- generatedChecksum: D0D11C3D2D1BD585018AE271E1AC3B8F
  logicalPath: FreeRTOS/Source/include
  name: stack_macros.h
  physicalPath: ../../third_party/rtos/FreeRTOS/Source/include
  security: NON_SECURE
  type: HEADER
  userChecksum: D0D11C3D2D1BD585018AE271E1AC3B8F
- generatedChecksum: 7C71A9D2BEF16AC21C17ED5C2452C263
  logicalPath: FreeRTOS/Source/include
  name: stream_buffer.h
  physicalPath: ../../third_party/rtos/FreeRTOS/Source/include
  security: NON_SECURE
  type: HEADER
  userChecksum: 7C71A9D2BEF16AC21C17ED5C2452C263
- generatedChecksum: 6972608768DDBE6E37A2D81B83DF490B
  logicalPath: config/default/system/debug
  name: sys_debug.h
  physicalPath: system/debug
  security: NON_SECURE
  type: HEADER
  userChecksum: 6972608768DDBE6E37A2D81B83DF490B
- generatedChecksum: 47330C2D8F204B2B69F8A86240A564B6
  logicalPath: config/default/system/int
  name: sys_int.h
  physicalPath: system/int
  security: NON_SECURE
  type: HEADER
  userChecksum: 47330C2D8F204B2B69F8A86240A564B6
- generatedChecksum: FC7B55936A09E0CA1395AE4DFB1A188F
  logicalPath: config/default/system/int
  name: sys_int_mapping.h
  physicalPath: system/int
  security: NON_SECURE
  type: HEADER
  userChecksum: FC7B55936A09E0CA1395AE4DFB1A188F
- generatedChecksum: 8E43BD17134E69982826F202D0AB42C5
  logicalPath: config/default/system/reset
  name: sys_reset.h
  physicalPath: system/reset
  security: NON_SECURE
  type: HEADER
  userChecksum: 8E43BD17134E69982826F202D0AB42C5
- generatedChecksum: BE95B4F134C5C929787B9DA6FDBF3501
  logicalPath: config/default/system
  name: system.h
  physicalPath: system
  security: NON_SECURE
  type: HEADER
  userChecksum: BE95B4F134C5C929787B9DA6FDBF3501
- generatedChecksum: C3F5136D520DAC4416512EBFCCA023C3
  logicalPath: config/default/system
  name: system_common.h
  physicalPath: system
  security: NON_SECURE
  type: HEADER
  userChecksum: C3F5136D520DAC4416512EBFCCA023C3
- generatedChecksum: 1C75A8A6B60598A2FD0D533F57839B72
  logicalPath: config/default/system
  name: system_module.h
  physicalPath: system
  security: NON_SECURE
  type: HEADER
  userChecksum: 1C75A8A6B60598A2FD0D533F57839B72
- generatedChecksum: 84B3224817BDD8B37961BB3B3441E134
  logicalPath: FreeRTOS/Source/include
  name: task.h
  physicalPath: ../../third_party/rtos/FreeRTOS/Source/include
  security: NON_SECURE
  type: HEADER
  userChecksum: 84B3224817BDD8B37961BB3B3441E134
- generatedChecksum: C8BB70E2423A57902E9FDC0C9EC81F8D
  logicalPath: FreeRTOS/Source/include
  name: timers.h
  physicalPath: ../../third_party/rtos/FreeRTOS/Source/include
  security: NON_SECURE
  type: HEADER
  userChecksum: C8BB70E2423A57902E9FDC0C9EC81F8D
- generatedChecksum: 7DC91D6D376C98802C9C2990432DE9B7
  logicalPath: config/default
  name: toolchain_specifics.h
  physicalPath: ''
  security: NON_SECURE
  type: HEADER
  userChecksum: 7DC91D6D376C98802C9C2990432DE9B7
- generatedChecksum: 7614490532C606BCAFEC5F729FDBEDAD
  logicalPath: config/default/driver/usb/usbfs/src/templates
  name: usb_ALL_Interrupt_Default.h
  physicalPath: driver/usb/usbfs/src/templates
  security: NON_SECURE
  type: HEADER
  userChecksum: 7614490532C606BCAFEC5F729FDBEDAD
- generatedChecksum: 745B8DF89B5477EADA7B0786F1491B4C
  logicalPath: config/default/driver/usb/usbfs/src/templates
  name: usb_ALL_Interrupt_Unsupported.h
  physicalPath: driver/usb/usbfs/src/templates
  security: NON_SECURE
  type: HEADER
  userChecksum: 745B8DF89B5477EADA7B0786F1491B4C
- generatedChecksum: 86227AAF459AA8589F50247D54E63EA1
  logicalPath: config/default/driver/usb/usbfs/src/templates
  name: usb_ActivityPending_Default.h
  physicalPath: driver/usb/usbfs/src/templates
  security: NON_SECURE
  type: HEADER
  userChecksum: 86227AAF459AA8589F50247D54E63EA1
- generatedChecksum: E86B513BFC354B734122E715E9673569
  logicalPath: config/default/driver/usb/usbfs/src/templates
  name: usb_ActivityPending_Unsupported.h
  physicalPath: driver/usb/usbfs/src/templates
  security: NON_SECURE
  type: HEADER
  userChecksum: E86B513BFC354B734122E715E9673569
- generatedChecksum: FCDC292B30CBCAE218A51F68C3ADD7B2
  logicalPath: config/default/driver/usb/usbfs/src/templates
  name: usb_AutomaticSuspend_Default.h
  physicalPath: driver/usb/usbfs/src/templates
  security: NON_SECURE
  type: HEADER
  userChecksum: FCDC292B30CBCAE218A51F68C3ADD7B2
- generatedChecksum: 4C2B2ED2E7617D6EFD806454B03D7BF8
  logicalPath: config/default/driver/usb/usbfs/src/templates
  name: usb_AutomaticSuspend_Unsupported.h
  physicalPath: driver/usb/usbfs/src/templates
  security: NON_SECURE
  type: HEADER
  userChecksum: 4C2B2ED2E7617D6EFD806454B03D7BF8
- generatedChecksum: 09A5E6FEB6CADD075F370EC5FF2733C8
  logicalPath: config/default/driver/usb/usbfs/src/templates
  name: usb_BDTBaseAddress_Default.h
  physicalPath: driver/usb/usbfs/src/templates
  security: NON_SECURE
  type: HEADER
  userChecksum: 09A5E6FEB6CADD075F370EC5FF2733C8
- generatedChecksum: 6ECAB19200B7B025B56DFC85D15369F4
  logicalPath: config/default/driver/usb/usbfs/src/templates
  name: usb_BDTBaseAddress_Unsupported.h
  physicalPath: driver/usb/usbfs/src/templates
  security: NON_SECURE
  type: HEADER
  userChecksum: 6ECAB19200B7B025B56DFC85D15369F4
- generatedChecksum: F11B46BCB5572997D5531BA60D331A21
  logicalPath: config/default/driver/usb/usbfs/src/templates
  name: usb_BDTFunctions_PIC32.h
  physicalPath: driver/usb/usbfs/src/templates
  security: NON_SECURE
  type: HEADER
  userChecksum: F11B46BCB5572997D5531BA60D331A21
- generatedChecksum: 62A57CF6942AF8E8B60B3B8771C53306
  logicalPath: config/default/driver/usb/usbfs/src/templates
  name: usb_BDTFunctions_Unsupported.h
  physicalPath: driver/usb/usbfs/src/templates
  security: NON_SECURE
  type: HEADER
  userChecksum: 62A57CF6942AF8E8B60B3B8771C53306
- generatedChecksum: EFDB80DE1EC77D54E76D2F3291142209
  logicalPath: config/default/driver/usb/usbfs/src/templates
  name: usb_BufferFreeze_Default.h
  physicalPath: driver/usb/usbfs/src/templates
  security: NON_SECURE
  type: HEADER
  userChecksum: EFDB80DE1EC77D54E76D2F3291142209
- generatedChecksum: 44A4CF72E79B206503A570A7C6B15CAD
  logicalPath: config/default/driver/usb/usbfs/src/templates
  name: usb_BufferFreeze_Unsupported.h
  physicalPath: driver/usb/usbfs/src/templates
  security: NON_SECURE
  type: HEADER
  userChecksum: 44A4CF72E79B206503A570A7C6B15CAD
- generatedChecksum: 10843324F0C3C37B9419EAD8FFB4B75E
  logicalPath: config/default/driver/usb/usbfs/src/templates
  name: usb_DeviceAddress_Default.h
  physicalPath: driver/usb/usbfs/src/templates
  security: NON_SECURE
  type: HEADER
  userChecksum: 10843324F0C3C37B9419EAD8FFB4B75E
- generatedChecksum: 54BFBC3F08C0D4752DF74799F4C9B449
  logicalPath: config/default/driver/usb/usbfs/src/templates
  name: usb_DeviceAddress_Unsupported.h
  physicalPath: driver/usb/usbfs/src/templates
  security: NON_SECURE
  type: HEADER
  userChecksum: 54BFBC3F08C0D4752DF74799F4C9B449
- generatedChecksum: 4D2630F1B71886CAF9503FE025AFF5EE
  logicalPath: config/default/driver/usb/usbfs/src/templates
  name: usb_EP0LowSpeedConnect_Default.h
  physicalPath: driver/usb/usbfs/src/templates
  security: NON_SECURE
  type: HEADER
  userChecksum: 4D2630F1B71886CAF9503FE025AFF5EE
- generatedChecksum: 19518D9996047F6F94CA2AA4902E9E7B
  logicalPath: config/default/driver/usb/usbfs/src/templates
  name: usb_EP0LowSpeedConnect_Unsupported.h
  physicalPath: driver/usb/usbfs/src/templates
  security: NON_SECURE
  type: HEADER
  userChecksum: 19518D9996047F6F94CA2AA4902E9E7B
- generatedChecksum: E7025F9FBA2413ED2AD4522B66DEDA9C
  logicalPath: config/default/driver/usb/usbfs/src/templates
  name: usb_EP0NAKRetry_Default.h
  physicalPath: driver/usb/usbfs/src/templates
  security: NON_SECURE
  type: HEADER
  userChecksum: E7025F9FBA2413ED2AD4522B66DEDA9C
- generatedChecksum: BE22CA76DBE5C80AB3E7A7D9C2B3C0DC
  logicalPath: config/default/driver/usb/usbfs/src/templates
  name: usb_EP0NAKRetry_Unsupported.h
  physicalPath: driver/usb/usbfs/src/templates
  security: NON_SECURE
  type: HEADER
  userChecksum: BE22CA76DBE5C80AB3E7A7D9C2B3C0DC
- generatedChecksum: A172572AB4A8E1076DC9543FCCD4CB65
  logicalPath: config/default/driver/usb/usbfs/src/templates
  name: usb_EPnControlTransfer_Default.h
  physicalPath: driver/usb/usbfs/src/templates
  security: NON_SECURE
  type: HEADER
  userChecksum: A172572AB4A8E1076DC9543FCCD4CB65
- generatedChecksum: 74220D1C57F227F60349E1B08EE06A98
  logicalPath: config/default/driver/usb/usbfs/src/templates
  name: usb_EPnControlTransfer_Unsupported.h
  physicalPath: driver/usb/usbfs/src/templates
  security: NON_SECURE
  type: HEADER
  userChecksum: 74220D1C57F227F60349E1B08EE06A98
- generatedChecksum: B2A9683B9EF845D691DBE7F61594836F
  logicalPath: config/default/driver/usb/usbfs/src/templates
  name: usb_EPnHandshake_Default.h
  physicalPath: driver/usb/usbfs/src/templates
  security: NON_SECURE
  type: HEADER
  userChecksum: B2A9683B9EF845D691DBE7F61594836F
- generatedChecksum: 7AA89118BF93853F1958AD8736D28B61
  logicalPath: config/default/driver/usb/usbfs/src/templates
  name: usb_EPnHandshake_Unsupported.h
  physicalPath: driver/usb/usbfs/src/templates
  security: NON_SECURE
  type: HEADER
  userChecksum: 7AA89118BF93853F1958AD8736D28B61
- generatedChecksum: 350B868A638E3EC481AA29B73D81622F
  logicalPath: config/default/driver/usb/usbfs/src/templates
  name: usb_EPnRxEnableEnhanced_PIC32.h
  physicalPath: driver/usb/usbfs/src/templates
  security: NON_SECURE
  type: HEADER
  userChecksum: 350B868A638E3EC481AA29B73D81622F
- generatedChecksum: B6C1F8C688E949B477CAE40A758D928C
  logicalPath: config/default/driver/usb/usbfs/src/templates
  name: usb_EPnRxEnableEnhanced_Unsupported.h
  physicalPath: driver/usb/usbfs/src/templates
  security: NON_SECURE
  type: HEADER
  userChecksum: B6C1F8C688E949B477CAE40A758D928C
- generatedChecksum: 34F5E74F7D49EE64CD92F9BEE2B8F7C9
  logicalPath: config/default/driver/usb/usbfs/src/templates
  name: usb_EPnStall_Default.h
  physicalPath: driver/usb/usbfs/src/templates
  security: NON_SECURE
  type: HEADER
  userChecksum: 34F5E74F7D49EE64CD92F9BEE2B8F7C9
- generatedChecksum: 0D383886A9E3659029E372AA369E04F0
  logicalPath: config/default/driver/usb/usbfs/src/templates
  name: usb_EPnStall_Unsupported.h
  physicalPath: driver/usb/usbfs/src/templates
  security: NON_SECURE
  type: HEADER
  userChecksum: 0D383886A9E3659029E372AA369E04F0
- generatedChecksum: A05787C93C388FF70D13BEDD156E9165
  logicalPath: config/default/driver/usb/usbfs/src/templates
  name: usb_EPnTxRx_Default.h
  physicalPath: driver/usb/usbfs/src/templates
  security: NON_SECURE
  type: HEADER
  userChecksum: A05787C93C388FF70D13BEDD156E9165
- generatedChecksum: F46E538F66BC67AB746DE5DC08335D18
  logicalPath: config/default/driver/usb/usbfs/src/templates
  name: usb_EPnTxRx_Unsupported.h
  physicalPath: driver/usb/usbfs/src/templates
  security: NON_SECURE
  type: HEADER
  userChecksum: F46E538F66BC67AB746DE5DC08335D18
- generatedChecksum: D91EF7D6D66318175EC902AC10B07541
  logicalPath: config/default/driver/usb/usbfs/src/templates
  name: usb_ERR_InterruptStatus_Default.h
  physicalPath: driver/usb/usbfs/src/templates
  security: NON_SECURE
  type: HEADER
  userChecksum: D91EF7D6D66318175EC902AC10B07541
- generatedChecksum: 13AFF95C87EB4F8C70972D2B27BD9315
  logicalPath: config/default/driver/usb/usbfs/src/templates
  name: usb_ERR_InterruptStatus_Unsupported.h
  physicalPath: driver/usb/usbfs/src/templates
  security: NON_SECURE
  type: HEADER
  userChecksum: 13AFF95C87EB4F8C70972D2B27BD9315
- generatedChecksum: 3266F05DC49F47AD8983E08695D228EB
  logicalPath: config/default/driver/usb/usbfs/src/templates
  name: usb_ERR_Interrupt_Default.h
  physicalPath: driver/usb/usbfs/src/templates
  security: NON_SECURE
  type: HEADER
  userChecksum: 3266F05DC49F47AD8983E08695D228EB
- generatedChecksum: 29467AB44D0B20289667E5E8696C81B6
  logicalPath: config/default/driver/usb/usbfs/src/templates
  name: usb_ERR_Interrupt_Unsupported.h
  physicalPath: driver/usb/usbfs/src/templates
  security: NON_SECURE
  type: HEADER
  userChecksum: 29467AB44D0B20289667E5E8696C81B6
- generatedChecksum: 6E6CFAA5FB99D2D377C7B7F194423195
  logicalPath: config/default/driver/usb/usbfs/src/templates
  name: usb_EyePattern_Default.h
  physicalPath: driver/usb/usbfs/src/templates
  security: NON_SECURE
  type: HEADER
  userChecksum: 6E6CFAA5FB99D2D377C7B7F194423195
- generatedChecksum: BAEA73C8C521F1ACCE710D4512F3FAE6
  logicalPath: config/default/driver/usb/usbfs/src/templates
  name: usb_EyePattern_Unsupported.h
  physicalPath: driver/usb/usbfs/src/templates
  security: NON_SECURE
  type: HEADER
  userChecksum: BAEA73C8C521F1ACCE710D4512F3FAE6
- generatedChecksum: 76B9CFCF5B06444BD689EAA1F22AD71D
  logicalPath: config/default/driver/usb/usbfs/src/templates
  name: usb_FrameNumber_Default.h
  physicalPath: driver/usb/usbfs/src/templates
  security: NON_SECURE
  type: HEADER
  userChecksum: 76B9CFCF5B06444BD689EAA1F22AD71D
- generatedChecksum: 408CB74019E2380B2BCD429049F1B981
  logicalPath: config/default/driver/usb/usbfs/src/templates
  name: usb_FrameNumber_Unsupported.h
  physicalPath: driver/usb/usbfs/src/templates
  security: NON_SECURE
  type: HEADER
  userChecksum: 408CB74019E2380B2BCD429049F1B981
- generatedChecksum: 6EB33D0EB60209522E91C7B805AB25DC
  logicalPath: config/default/driver/usb/usbfs/src/templates
  name: usb_GEN_InterruptStatus_Default.h
  physicalPath: driver/usb/usbfs/src/templates
  security: NON_SECURE
  type: HEADER
  userChecksum: 6EB33D0EB60209522E91C7B805AB25DC
- generatedChecksum: 3360F2D7F303E408D8F581FC44A6DE3C
  logicalPath: config/default/driver/usb/usbfs/src/templates
  name: usb_GEN_InterruptStatus_Unsupported.h
  physicalPath: driver/usb/usbfs/src/templates
  security: NON_SECURE
  type: HEADER
  userChecksum: 3360F2D7F303E408D8F581FC44A6DE3C
- generatedChecksum: 980B20058F736B07F71A233527B55809
  logicalPath: config/default/driver/usb/usbfs/src/templates
  name: usb_GEN_Interrupt_Default.h
  physicalPath: driver/usb/usbfs/src/templates
  security: NON_SECURE
  type: HEADER
  userChecksum: 980B20058F736B07F71A233527B55809
- generatedChecksum: 54F632B5226E20C4685BB6069D995765
  logicalPath: config/default/driver/usb/usbfs/src/templates
  name: usb_GEN_Interrupt_Unsupported.h
  physicalPath: driver/usb/usbfs/src/templates
  security: NON_SECURE
  type: HEADER
  userChecksum: 54F632B5226E20C4685BB6069D995765
- generatedChecksum: 048544CF9B6F68C7EBD7D78ECBFEDA59
  logicalPath: config/default/driver/usb/usbfs/src/templates
  name: usb_HostBusyWithToken_Default.h
  physicalPath: driver/usb/usbfs/src/templates
  security: NON_SECURE
  type: HEADER
  userChecksum: 048544CF9B6F68C7EBD7D78ECBFEDA59
- generatedChecksum: B6C53AAB216360C9BBAE677366BC9890
  logicalPath: config/default/driver/usb/usbfs/src/templates
  name: usb_HostBusyWithToken_Unsupported.h
  physicalPath: driver/usb/usbfs/src/templates
  security: NON_SECURE
  type: HEADER
  userChecksum: B6C53AAB216360C9BBAE677366BC9890
- generatedChecksum: 65F3253730F0AA1AB36C4512A52794FB
  logicalPath: config/default/driver/usb/usbfs/src/templates
  name: usb_HostGeneratesReset_Default.h
  physicalPath: driver/usb/usbfs/src/templates
  security: NON_SECURE
  type: HEADER
  userChecksum: 65F3253730F0AA1AB36C4512A52794FB
- generatedChecksum: 6623665EA8F1449332618060E20D196B
  logicalPath: config/default/driver/usb/usbfs/src/templates
  name: usb_HostGeneratesReset_Unsupported.h
  physicalPath: driver/usb/usbfs/src/templates
  security: NON_SECURE
  type: HEADER
  userChecksum: 6623665EA8F1449332618060E20D196B
- generatedChecksum: B7CF190EB03BA59B93C489D8994926CC
  logicalPath: config/default/driver/usb/usbfs/src/templates
  name: usb_LastDirection_Default.h
  physicalPath: driver/usb/usbfs/src/templates
  security: NON_SECURE
  type: HEADER
  userChecksum: B7CF190EB03BA59B93C489D8994926CC
- generatedChecksum: 625AB3F01773E229D8CCFEB1006C7CD2
  logicalPath: config/default/driver/usb/usbfs/src/templates
  name: usb_LastDirection_Unsupported.h
  physicalPath: driver/usb/usbfs/src/templates
  security: NON_SECURE
  type: HEADER
  userChecksum: 625AB3F01773E229D8CCFEB1006C7CD2
- generatedChecksum: 60810E675DF84F16A02B0D0EAD6D7F63
  logicalPath: config/default/driver/usb/usbfs/src/templates
  name: usb_LastEndpoint_Default.h
  physicalPath: driver/usb/usbfs/src/templates
  security: NON_SECURE
  type: HEADER
  userChecksum: 60810E675DF84F16A02B0D0EAD6D7F63
- generatedChecksum: 82F028EFD6BEB1C80F9B9292831A65D9
  logicalPath: config/default/driver/usb/usbfs/src/templates
  name: usb_LastEndpoint_Unsupported.h
  physicalPath: driver/usb/usbfs/src/templates
  security: NON_SECURE
  type: HEADER
  userChecksum: 82F028EFD6BEB1C80F9B9292831A65D9
- generatedChecksum: 9A2A474F2CFED908346E87E36C2D79F2
  logicalPath: config/default/driver/usb/usbfs/src/templates
  name: usb_LastPingPong_Default.h
  physicalPath: driver/usb/usbfs/src/templates
  security: NON_SECURE
  type: HEADER
  userChecksum: 9A2A474F2CFED908346E87E36C2D79F2
- generatedChecksum: 058EAAB655838DA5289D587DDAC32CAA
  logicalPath: config/default/driver/usb/usbfs/src/templates
  name: usb_LastPingPong_Unsupported.h
  physicalPath: driver/usb/usbfs/src/templates
  security: NON_SECURE
  type: HEADER
  userChecksum: 058EAAB655838DA5289D587DDAC32CAA
- generatedChecksum: 33E50D04E85804ADE7171A8376C42424
  logicalPath: config/default/driver/usb/usbfs/src/templates
  name: usb_LastTransactionDetails_Default.h
  physicalPath: driver/usb/usbfs/src/templates
  security: NON_SECURE
  type: HEADER
  userChecksum: 33E50D04E85804ADE7171A8376C42424
- generatedChecksum: EB7BEA76434E3AC1308285FBAB01B13F
  logicalPath: config/default/driver/usb/usbfs/src/templates
  name: usb_LastTransactionDetails_Unsupported.h
  physicalPath: driver/usb/usbfs/src/templates
  security: NON_SECURE
  type: HEADER
  userChecksum: EB7BEA76434E3AC1308285FBAB01B13F
- generatedChecksum: 5F6530DD94D66305E91832C300436D8C
  logicalPath: config/default/driver/usb/usbfs/src/templates
  name: usb_LiveJState_Default.h
  physicalPath: driver/usb/usbfs/src/templates
  security: NON_SECURE
  type: HEADER
  userChecksum: 5F6530DD94D66305E91832C300436D8C
- generatedChecksum: 6B6273C05B158120AC6D38BAAF663D3B
  logicalPath: config/default/driver/usb/usbfs/src/templates
  name: usb_LiveJState_Unsupported.h
  physicalPath: driver/usb/usbfs/src/templates
  security: NON_SECURE
  type: HEADER
  userChecksum: 6B6273C05B158120AC6D38BAAF663D3B
- generatedChecksum: 30F8DF0AF32CB6257839B7AEB898A46F
  logicalPath: config/default/driver/usb/usbfs/src/templates
  name: usb_LiveSingleEndedZero_Default.h
  physicalPath: driver/usb/usbfs/src/templates
  security: NON_SECURE
  type: HEADER
  userChecksum: 30F8DF0AF32CB6257839B7AEB898A46F
- generatedChecksum: 134E5C20D6CA8AED76B4037DB9A09AB7
  logicalPath: config/default/driver/usb/usbfs/src/templates
  name: usb_LiveSingleEndedZero_Unsupported.h
  physicalPath: driver/usb/usbfs/src/templates
  security: NON_SECURE
  type: HEADER
  userChecksum: 134E5C20D6CA8AED76B4037DB9A09AB7
- generatedChecksum: 2422148BA969698923685283F46C92E9
  logicalPath: config/default/driver/usb/usbfs/src/templates
  name: usb_ModuleBusy_Default.h
  physicalPath: driver/usb/usbfs/src/templates
  security: NON_SECURE
  type: HEADER
  userChecksum: 2422148BA969698923685283F46C92E9
- generatedChecksum: 167442BF79AE0D75BFBED51A312C6EE1
  logicalPath: config/default/driver/usb/usbfs/src/templates
  name: usb_ModuleBusy_Unsupported.h
  physicalPath: driver/usb/usbfs/src/templates
  security: NON_SECURE
  type: HEADER
  userChecksum: 167442BF79AE0D75BFBED51A312C6EE1
- generatedChecksum: E2E2A24D754C152E0273ACE870235103
  logicalPath: config/default/driver/usb/usbfs/src/templates
  name: usb_ModulePower_32Bit16Bit.h
  physicalPath: driver/usb/usbfs/src/templates
  security: NON_SECURE
  type: HEADER
  userChecksum: E2E2A24D754C152E0273ACE870235103
- generatedChecksum: A53F5BE327C6E2F3D218EF3C9F5C6EEF
  logicalPath: config/default/driver/usb/usbfs/src/templates
  name: usb_ModulePower_Unsupported.h
  physicalPath: driver/usb/usbfs/src/templates
  security: NON_SECURE
  type: HEADER
  userChecksum: A53F5BE327C6E2F3D218EF3C9F5C6EEF
- generatedChecksum: E2B3981232810DC07B12BB0F413B787B
  logicalPath: config/default/driver/usb/usbfs/src/templates
  name: usb_NextTokenSpeed_Default.h
  physicalPath: driver/usb/usbfs/src/templates
  security: NON_SECURE
  type: HEADER
  userChecksum: E2B3981232810DC07B12BB0F413B787B
- generatedChecksum: 9513196BF2783545C5B62361D943437D
  logicalPath: config/default/driver/usb/usbfs/src/templates
  name: usb_NextTokenSpeed_Unsupported.h
  physicalPath: driver/usb/usbfs/src/templates
  security: NON_SECURE
  type: HEADER
  userChecksum: 9513196BF2783545C5B62361D943437D
- generatedChecksum: 38BE3303E98314C627DA67AC076C3F09
  logicalPath: config/default/driver/usb/usbfs/src/templates
  name: usb_OTG_ASessionValid_Default.h
  physicalPath: driver/usb/usbfs/src/templates
  security: NON_SECURE
  type: HEADER
  userChecksum: 38BE3303E98314C627DA67AC076C3F09
- generatedChecksum: 5352DFCC35451F729FA0911037218B86
  logicalPath: config/default/driver/usb/usbfs/src/templates
  name: usb_OTG_ASessionValid_Unsupported.h
  physicalPath: driver/usb/usbfs/src/templates
  security: NON_SECURE
  type: HEADER
  userChecksum: 5352DFCC35451F729FA0911037218B86
- generatedChecksum: 36A534DD422BA20FA2AE8EFF18DA8039
  logicalPath: config/default/driver/usb/usbfs/src/templates
  name: usb_OTG_BSessionEnd_Default.h
  physicalPath: driver/usb/usbfs/src/templates
  security: NON_SECURE
  type: HEADER
  userChecksum: 36A534DD422BA20FA2AE8EFF18DA8039
- generatedChecksum: FA19A265F10A2C91948E37C137599B24
  logicalPath: config/default/driver/usb/usbfs/src/templates
  name: usb_OTG_BSessionEnd_Unsupported.h
  physicalPath: driver/usb/usbfs/src/templates
  security: NON_SECURE
  type: HEADER
  userChecksum: FA19A265F10A2C91948E37C137599B24
- generatedChecksum: 84C73320F432149F92318F74E8496122
  logicalPath: config/default/driver/usb/usbfs/src/templates
  name: usb_OTG_IDPinState_Default.h
  physicalPath: driver/usb/usbfs/src/templates
  security: NON_SECURE
  type: HEADER
  userChecksum: 84C73320F432149F92318F74E8496122
- generatedChecksum: 7128C610EC9A82EBDCBCB3BFDC6FF31E
  logicalPath: config/default/driver/usb/usbfs/src/templates
  name: usb_OTG_IDPinState_Unsupported.h
  physicalPath: driver/usb/usbfs/src/templates
  security: NON_SECURE
  type: HEADER
  userChecksum: 7128C610EC9A82EBDCBCB3BFDC6FF31E
- generatedChecksum: D1A36D8ACF5801EACF74063F1F7C8724
  logicalPath: config/default/driver/usb/usbfs/src/templates
  name: usb_OTG_InterruptStatus_Default.h
  physicalPath: driver/usb/usbfs/src/templates
  security: NON_SECURE
  type: HEADER
  userChecksum: D1A36D8ACF5801EACF74063F1F7C8724
- generatedChecksum: D551EA6473C70608F3B158FC41103424
  logicalPath: config/default/driver/usb/usbfs/src/templates
  name: usb_OTG_InterruptStatus_Unsupported.h
  physicalPath: driver/usb/usbfs/src/templates
  security: NON_SECURE
  type: HEADER
  userChecksum: D551EA6473C70608F3B158FC41103424
- generatedChecksum: 8106E66B318C78D4F5BCF81A7F9AB47A
  logicalPath: config/default/driver/usb/usbfs/src/templates
  name: usb_OTG_Interrupt_Default.h
  physicalPath: driver/usb/usbfs/src/templates
  security: NON_SECURE
  type: HEADER
  userChecksum: 8106E66B318C78D4F5BCF81A7F9AB47A
- generatedChecksum: D54E0303FC83CE7061086D7D9C416DFB
  logicalPath: config/default/driver/usb/usbfs/src/templates
  name: usb_OTG_Interrupt_Unsupported.h
  physicalPath: driver/usb/usbfs/src/templates
  security: NON_SECURE
  type: HEADER
  userChecksum: D54E0303FC83CE7061086D7D9C416DFB
- generatedChecksum: 5CE79190E2C8E1130DBA5FA0B133C905
  logicalPath: config/default/driver/usb/usbfs/src/templates
  name: usb_OTG_LineState_Default.h
  physicalPath: driver/usb/usbfs/src/templates
  security: NON_SECURE
  type: HEADER
  userChecksum: 5CE79190E2C8E1130DBA5FA0B133C905
- generatedChecksum: 39D144A10029BEF9EB84994C93C9F97C
  logicalPath: config/default/driver/usb/usbfs/src/templates
  name: usb_OTG_LineState_Unsupported.h
  physicalPath: driver/usb/usbfs/src/templates
  security: NON_SECURE
  type: HEADER
  userChecksum: 39D144A10029BEF9EB84994C93C9F97C
- generatedChecksum: 749259B13336B1A48E3A212CC8E76A10
  logicalPath: config/default/driver/usb/usbfs/src/templates
  name: usb_OTG_PullUpPullDown_Default.h
  physicalPath: driver/usb/usbfs/src/templates
  security: NON_SECURE
  type: HEADER
  userChecksum: 749259B13336B1A48E3A212CC8E76A10
- generatedChecksum: 603005C43494A7B577DDFDC072F38934
  logicalPath: config/default/driver/usb/usbfs/src/templates
  name: usb_OTG_PullUpPullDown_Unsupported.h
  physicalPath: driver/usb/usbfs/src/templates
  security: NON_SECURE
  type: HEADER
  userChecksum: 603005C43494A7B577DDFDC072F38934
- generatedChecksum: F53CDCE8B12DC50609F738356C557D7C
  logicalPath: config/default/driver/usb/usbfs/src/templates
  name: usb_OTG_SessionValid_Default.h
  physicalPath: driver/usb/usbfs/src/templates
  security: NON_SECURE
  type: HEADER
  userChecksum: F53CDCE8B12DC50609F738356C557D7C
- generatedChecksum: 2E1C89EE866754BA6E3716C01F81840A
  logicalPath: config/default/driver/usb/usbfs/src/templates
  name: usb_OTG_SessionValid_Unsupported.h
  physicalPath: driver/usb/usbfs/src/templates
  security: NON_SECURE
  type: HEADER
  userChecksum: 2E1C89EE866754BA6E3716C01F81840A
- generatedChecksum: 169EF167B1CA3EE3432083DDB9A4DF68
  logicalPath: config/default/driver/usb/usbfs/src/templates
  name: usb_OTG_VbusCharge_Default.h
  physicalPath: driver/usb/usbfs/src/templates
  security: NON_SECURE
  type: HEADER
  userChecksum: 169EF167B1CA3EE3432083DDB9A4DF68
- generatedChecksum: 83BE346B5A9706159421BA8A882BC654
  logicalPath: config/default/driver/usb/usbfs/src/templates
  name: usb_OTG_VbusCharge_Unsupported.h
  physicalPath: driver/usb/usbfs/src/templates
  security: NON_SECURE
  type: HEADER
  userChecksum: 83BE346B5A9706159421BA8A882BC654
- generatedChecksum: CCED5CAFC52EA7EBAB9C7EA633F94FBD
  logicalPath: config/default/driver/usb/usbfs/src/templates
  name: usb_OTG_VbusDischarge_Default.h
  physicalPath: driver/usb/usbfs/src/templates
  security: NON_SECURE
  type: HEADER
  userChecksum: CCED5CAFC52EA7EBAB9C7EA633F94FBD
- generatedChecksum: F18FCAF76F4FE96F560CAC9D61883E10
  logicalPath: config/default/driver/usb/usbfs/src/templates
  name: usb_OTG_VbusDischarge_Unsupported.h
  physicalPath: driver/usb/usbfs/src/templates
  security: NON_SECURE
  type: HEADER
  userChecksum: F18FCAF76F4FE96F560CAC9D61883E10
- generatedChecksum: 256E24F8D6407783D550D7EE34DC5454
  logicalPath: config/default/driver/usb/usbfs/src/templates
  name: usb_OTG_VbusPowerOnOff_Default.h
  physicalPath: driver/usb/usbfs/src/templates
  security: NON_SECURE
  type: HEADER
  userChecksum: 256E24F8D6407783D550D7EE34DC5454
- generatedChecksum: A5FDE90F969D0F5EC080DCA1336EC551
  logicalPath: config/default/driver/usb/usbfs/src/templates
  name: usb_OTG_VbusPowerOnOff_Unsupported.h
  physicalPath: driver/usb/usbfs/src/templates
  security: NON_SECURE
  type: HEADER
  userChecksum: A5FDE90F969D0F5EC080DCA1336EC551
- generatedChecksum: 09E1D9F5F5E052007AF0A26348B8F59A
  logicalPath: config/default/driver/usb/usbfs/src/templates
  name: usb_OnChipPullup_Unsupported.h
  physicalPath: driver/usb/usbfs/src/templates
  security: NON_SECURE
  type: HEADER
  userChecksum: 09E1D9F5F5E052007AF0A26348B8F59A
- generatedChecksum: E9695732C30EACDBA9345D94C37D4417
  logicalPath: config/default/driver/usb/usbfs/src/templates
  name: usb_OnChipTransceiver_Unsupported.h
  physicalPath: driver/usb/usbfs/src/templates
  security: NON_SECURE
  type: HEADER
  userChecksum: E9695732C30EACDBA9345D94C37D4417
- generatedChecksum: 4909CC4C2573CDE282AF965174A8C73F
  logicalPath: config/default/driver/usb/usbfs/src/templates
  name: usb_OpModeSelect_Default.h
  physicalPath: driver/usb/usbfs/src/templates
  security: NON_SECURE
  type: HEADER
  userChecksum: 4909CC4C2573CDE282AF965174A8C73F
- generatedChecksum: 08A0CD4EEF17F405055CD252FBCF396D
  logicalPath: config/default/driver/usb/usbfs/src/templates
  name: usb_OpModeSelect_Unsupported.h
  physicalPath: driver/usb/usbfs/src/templates
  security: NON_SECURE
  type: HEADER
  userChecksum: 08A0CD4EEF17F405055CD252FBCF396D
- generatedChecksum: D67E34356E44DDADFD0FEF511E82C4F6
  logicalPath: config/default/driver/usb/usbfs/src/templates
  name: usb_PacketTransfer_Default.h
  physicalPath: driver/usb/usbfs/src/templates
  security: NON_SECURE
  type: HEADER
  userChecksum: D67E34356E44DDADFD0FEF511E82C4F6
- generatedChecksum: 96CF545A48CBE1FD23CC65374F22816B
  logicalPath: config/default/driver/usb/usbfs/src/templates
  name: usb_PacketTransfer_Unsupported.h
  physicalPath: driver/usb/usbfs/src/templates
  security: NON_SECURE
  type: HEADER
  userChecksum: 96CF545A48CBE1FD23CC65374F22816B
- generatedChecksum: 9414911A8C7113A0DE499DAC504F8EC8
  logicalPath: config/default/driver/usb/usbfs/src/templates
  name: usb_PingPongMode_Unsupported.h
  physicalPath: driver/usb/usbfs/src/templates
  security: NON_SECURE
  type: HEADER
  userChecksum: 9414911A8C7113A0DE499DAC504F8EC8
- generatedChecksum: 36A4207833DBBB09794F91FB4CE02DE0
  logicalPath: config/default/driver/usb/usbfs/src/templates
  name: usb_ResumeSignaling_Default.h
  physicalPath: driver/usb/usbfs/src/templates
  security: NON_SECURE
  type: HEADER
  userChecksum: 36A4207833DBBB09794F91FB4CE02DE0
- generatedChecksum: F1CE5B84B9774E099FC20869BD88D848
  logicalPath: config/default/driver/usb/usbfs/src/templates
  name: usb_ResumeSignaling_Unsupported.h
  physicalPath: driver/usb/usbfs/src/templates
  security: NON_SECURE
  type: HEADER
  userChecksum: F1CE5B84B9774E099FC20869BD88D848
- generatedChecksum: 2EDA2AF4702BFC856F32A7C394F1CA3D
  logicalPath: config/default/driver/usb/usbfs/src/templates
  name: usb_SOFThreshold_Default.h
  physicalPath: driver/usb/usbfs/src/templates
  security: NON_SECURE
  type: HEADER
  userChecksum: 2EDA2AF4702BFC856F32A7C394F1CA3D
- generatedChecksum: 173533D9D44F34EAC6A43805F513C5BB
  logicalPath: config/default/driver/usb/usbfs/src/templates
  name: usb_SOFThreshold_Unsupported.h
  physicalPath: driver/usb/usbfs/src/templates
  security: NON_SECURE
  type: HEADER
  userChecksum: 173533D9D44F34EAC6A43805F513C5BB
- generatedChecksum: D130FC249330270320088204690E6E69
  logicalPath: config/default/driver/usb/usbfs/src/templates
  name: usb_SleepEntryGuard_Default.h
  physicalPath: driver/usb/usbfs/src/templates
  security: NON_SECURE
  type: HEADER
  userChecksum: D130FC249330270320088204690E6E69
- generatedChecksum: 22AF76F4008304D97083432006CE7B3C
  logicalPath: config/default/driver/usb/usbfs/src/templates
  name: usb_SleepEntryGuard_Unsupported.h
  physicalPath: driver/usb/usbfs/src/templates
  security: NON_SECURE
  type: HEADER
  userChecksum: 22AF76F4008304D97083432006CE7B3C
- generatedChecksum: 43AC410D2E57BEDBEDBA5CEB27E39C85
  logicalPath: config/default/driver/usb/usbfs/src/templates
  name: usb_SpeedControl_Unsupported.h
  physicalPath: driver/usb/usbfs/src/templates
  security: NON_SECURE
  type: HEADER
  userChecksum: 43AC410D2E57BEDBEDBA5CEB27E39C85
- generatedChecksum: D009D85E4B81A1B1C348D6B41AB33556
  logicalPath: config/default/driver/usb/usbfs/src/templates
  name: usb_StartOfFrames_Default.h
  physicalPath: driver/usb/usbfs/src/templates
  security: NON_SECURE
  type: HEADER
  userChecksum: D009D85E4B81A1B1C348D6B41AB33556
- generatedChecksum: 80E4E33CD6C02C4AF9EC825D4628B8CE
  logicalPath: config/default/driver/usb/usbfs/src/templates
  name: usb_StartOfFrames_Unsupported.h
  physicalPath: driver/usb/usbfs/src/templates
  security: NON_SECURE
  type: HEADER
  userChecksum: 80E4E33CD6C02C4AF9EC825D4628B8CE
- generatedChecksum: BFB7D5B997ADAB1B881165EBCE26C408
  logicalPath: config/default/driver/usb/usbfs/src/templates
  name: usb_StopInIdle_Default.h
  physicalPath: driver/usb/usbfs/src/templates
  security: NON_SECURE
  type: HEADER
  userChecksum: BFB7D5B997ADAB1B881165EBCE26C408
- generatedChecksum: D8718B32B3BCE26F4B03AF46971ACF34
  logicalPath: config/default/driver/usb/usbfs/src/templates
  name: usb_StopInIdle_Unsupported.h
  physicalPath: driver/usb/usbfs/src/templates
  security: NON_SECURE
  type: HEADER
  userChecksum: D8718B32B3BCE26F4B03AF46971ACF34
- generatedChecksum: D88042DD257B1A0841E72FF9E8A53768
  logicalPath: config/default/driver/usb/usbfs/src/templates
  name: usb_Suspend_Default.h
  physicalPath: driver/usb/usbfs/src/templates
  security: NON_SECURE
  type: HEADER
  userChecksum: D88042DD257B1A0841E72FF9E8A53768
- generatedChecksum: F450A2CB5B56FB19B09D89481F6B6D9C
  logicalPath: config/default/driver/usb/usbfs/src/templates
  name: usb_Suspend_Unsupported.h
  physicalPath: driver/usb/usbfs/src/templates
  security: NON_SECURE
  type: HEADER
  userChecksum: F450A2CB5B56FB19B09D89481F6B6D9C
- generatedChecksum: 37B19C89A43207CF77661935E8D2188B
  logicalPath: config/default/driver/usb/usbfs/src/templates
  name: usb_TokenEP_Default.h
  physicalPath: driver/usb/usbfs/src/templates
  security: NON_SECURE
  type: HEADER
  userChecksum: 37B19C89A43207CF77661935E8D2188B
- generatedChecksum: AAAF6430E674ED656EBD9939AF79EB82
  logicalPath: config/default/driver/usb/usbfs/src/templates
  name: usb_TokenEP_Unsupported.h
  physicalPath: driver/usb/usbfs/src/templates
  security: NON_SECURE
  type: HEADER
  userChecksum: AAAF6430E674ED656EBD9939AF79EB82
- generatedChecksum: 6B9BA1140FB58631035F927EAF5E9AE5
  logicalPath: config/default/driver/usb/usbfs/src/templates
  name: usb_TokenPID_Default.h
  physicalPath: driver/usb/usbfs/src/templates
  security: NON_SECURE
  type: HEADER
  userChecksum: 6B9BA1140FB58631035F927EAF5E9AE5
- generatedChecksum: 979F4D2846A355BE6DF6DD0D02D82AE0
  logicalPath: config/default/driver/usb/usbfs/src/templates
  name: usb_TokenPID_Unsupported.h
  physicalPath: driver/usb/usbfs/src/templates
  security: NON_SECURE
  type: HEADER
  userChecksum: 979F4D2846A355BE6DF6DD0D02D82AE0
- generatedChecksum: E67575175AA2DF30E077E4F10646158E
  logicalPath: config/default/driver/usb/usbfs/src/templates
  name: usb_UOEMonitor_Unsupported.h
  physicalPath: driver/usb/usbfs/src/templates
  security: NON_SECURE
  type: HEADER
  userChecksum: E67575175AA2DF30E077E4F10646158E
- generatedChecksum: 39659CDE2CC726544BD68544FB7EF4B2
  logicalPath: config/default/usb
  name: usb_chapter_9.h
  physicalPath: usb
  security: NON_SECURE
  type: HEADER
  userChecksum: 39659CDE2CC726544BD68544FB7EF4B2
- generatedChecksum: E7B6EAD8687A8EBC0355E0CE413B6A87
  logicalPath: config/default/usb
  name: usb_common.h
  physicalPath: usb
  security: NON_SECURE
  type: HEADER
  userChecksum: E7B6EAD8687A8EBC0355E0CE413B6A87
- generatedChecksum: 68F7DBD311EDCAF1098CDF2FD15B8C73
  logicalPath: config/default/usb
  name: usb_device.h
  physicalPath: usb
  security: NON_SECURE
  type: HEADER
  userChecksum: 68F7DBD311EDCAF1098CDF2FD15B8C73
- generatedChecksum: 626BFDDD140B808E90C9DD2E4A27421E
  logicalPath: config/default/usb/src
  name: usb_device_function_driver.h
  physicalPath: usb/src
  security: NON_SECURE
  type: HEADER
  userChecksum: 626BFDDD140B808E90C9DD2E4A27421E
- generatedChecksum: 144BD1138A70A9AA387E3742DB6E7448
  logicalPath: config/default/usb
  name: usb_device_hid.h
  physicalPath: usb
  security: NON_SECURE
  type: HEADER
  userChecksum: 144BD1138A70A9AA387E3742DB6E7448
- generatedChecksum: 6C72D678DC0100860FD1086BCF4A22C5
  logicalPath: config/default/usb/src
  name: usb_device_hid_local.h
  physicalPath: usb/src
  security: NON_SECURE
  type: HEADER
  userChecksum: 6C72D678DC0100860FD1086BCF4A22C5
- generatedChecksum: 9B727D396CAEBD5FCB12F1F8264C4FD9
  logicalPath: config/default/usb/src
  name: usb_device_local.h
  physicalPath: usb/src
  security: NON_SECURE
  type: HEADER
  userChecksum: 9B727D396CAEBD5FCB12F1F8264C4FD9
- generatedChecksum: C8D4A1D9092FD842506F565CE9B8C265
  logicalPath: config/default/usb/src
  name: usb_device_mapping.h
  physicalPath: usb/src
  security: NON_SECURE
  type: HEADER
  userChecksum: C8D4A1D9092FD842506F565CE9B8C265
- generatedChecksum: 6C4A6859DB16EA8C046F995C6B6C1C6F
  logicalPath: config/default/usb/src
  name: usb_external_dependencies.h
  physicalPath: usb/src
  security: NON_SECURE
  type: HEADER
  userChecksum: 6C4A6859DB16EA8C046F995C6B6C1C6F
- generatedChecksum: F258661D72F9E844BF936D43BF859BE7
  logicalPath: config/default/usb
  name: usb_hid.h
  physicalPath: usb
  security: NON_SECURE
  type: HEADER
  userChecksum: F258661D72F9E844BF936D43BF859BE7
- generatedChecksum: 6EB8F9F4A43B9BC2C7A58585AC679650
  logicalPath: config/default/usb
  name: usb_host.h
  physicalPath: usb
  security: NON_SECURE
  type: HEADER
  userChecksum: 6EB8F9F4A43B9BC2C7A58585AC679650
- generatedChecksum: 6EBC5E4D06FC96A02ADF3B7416957DD6
  logicalPath: config/default/usb
  name: usb_host_client_driver.h
  physicalPath: usb
  security: NON_SECURE
  type: HEADER
  userChecksum: 6EBC5E4D06FC96A02ADF3B7416957DD6
- generatedChecksum: 757C8484C955543C893361992D11FD4C
  logicalPath: config/default/usb
  name: usb_host_hub_interface.h
  physicalPath: usb
  security: NON_SECURE
  type: HEADER
  userChecksum: 757C8484C955543C893361992D11FD4C
- generatedChecksum: 3E3CC6BC9128194CB4D19F29C57E312B
  logicalPath: config/default/usb
  name: usb_hub.h
  physicalPath: usb
  security: NON_SECURE
  type: HEADER
  userChecksum: 3E3CC6BC9128194CB4D19F29C57E312B
- generatedChecksum: 6C8C42002A3EF221532D06F809FDD69A
  logicalPath: config/default/driver/usb/usbfs/src
  name: usbfs_registers.h
  physicalPath: driver/usb/usbfs/src
  security: NON_SECURE
  type: HEADER
  userChecksum: 6C8C42002A3EF221532D06F809FDD69A
- generatedChecksum: D048A36DC93E66C9CA02E4D6CD9827B9
  logicalPath: config/default/driver/usb/usbfs/src/templates
  name: usbfs_registers.h
  physicalPath: driver/usb/usbfs/src/templates
  security: NON_SECURE
  type: HEADER
  userChecksum: D048A36DC93E66C9CA02E4D6CD9827B9
- generatedChecksum: null
  logicalPath: config/default
  name: user.h
  physicalPath: ''
  security: NON_SECURE
  type: HEADER
  userChecksum: null
- generatedChecksum: CB2E9CFBC48EFCE35B77E2704C45A2B7
  logicalPath: config/default
  name: p32MK1024GPK064.ld
  physicalPath: ''
  security: NON_SECURE
  type: LINKER
  userChecksum: CB2E9CFBC48EFCE35B77E2704C45A2B7
format_version: v1.0
libraries: []
settings:
- append: true
  category: C32
  delimiter: ;
  key: extra-include-directories
  security: NON_SECURE
  value: ../src/third_party/rtos/FreeRTOS/Source/portable/MPLAB/PIC32MK;../src/third_party/rtos/FreeRTOS/Source/include;
- append: true
  category: C32
  delimiter: ;
  key: extra-include-directories
  security: NON_SECURE
  value: ../src;../src/config/default;
- append: false
  category: C32
  delimiter: ''
  key: generate-micro-compressed-code
  security: NON_SECURE
  value: 'false'
- append: true
  category: C32-AS
  delimiter: ;
  key: extra-include-directories-for-assembler
  security: NON_SECURE
  value: ../src/third_party/rtos/FreeRTOS/Source/portable/MPLAB/PIC32MK;../src/third_party/rtos/FreeRTOS/Source/include;../src/config/default;
- append: true
  category: C32-AS
  delimiter: ;
  key: extra-include-directories-for-preprocessor
  security: NON_SECURE
  value: ../src/third_party/rtos/FreeRTOS/Source/portable/MPLAB/PIC32MK;../src/third_party/rtos/FreeRTOS/Source/include;../src/config/default;
- append: false
  category: C32-LD
  delimiter: ''
  key: heap-size
  security: NON_SECURE
  value: '512'
- append: false
  category: C32-LD
  delimiter: ''
  key: no-device-startup-code
  security: NON_SECURE
  value: 'true'
- append: true
  category: C32-LD
  delimiter: ;=
  key: preprocessor-macros
  security: NON_SECURE
  value: ''
- append: true
  category: C32CPP
  delimiter: ;
  key: extra-include-directories
  security: NON_SECURE
  value: ../src/third_party/rtos/FreeRTOS/Source/portable/MPLAB/PIC32MK;../src/third_party/rtos/FreeRTOS/Source/include;
- append: true
  category: C32CPP
  delimiter: ;
  key: extra-include-directories
  security: NON_SECURE
  value: ../src;../src/config/default;
- append: false
  category: C32CPP
  delimiter: ''
  key: generate-micro-compressed-code
  security: NON_SECURE
  value: 'false'
sourcePaths: []
