bemcgarvey/RX12G/firmware/src/gyroTask.c

/////////////////////////////////////////////////////
// Project: RX12G                                  //
// File: gyroTask.c                                //
// Target: PIC32MK1024GPK064                       // 
// Compiler: XC32                                  //
// Author: Brad McGarvey                           //
// License: GNU General Public License v3.0        //
// Description: gyro and stability code            //
/////////////////////////////////////////////////////

#include "definitions.h"
#include "gyroTask.h"
#include "rtosHandles.h"
#include "output.h"
#include "tasks.h"
#include "attitude.h"
#include "autoLevel.h"
#include "rxTask.h"
#include "imu.h"
#include "launchAssist.h"
#include "normalMode.h"
#include "attitudeLock.h"
#include "trainer.h"
#include "angleMode.h"

TaskHandle_t gyroTaskHandle;
FlightModeType currentFlightMode = OFF_MODE;
float rollGains[3];
float pitchGains[3];
float yawGains[3];
volatile uint16_t rawServoPositions[MAX_CHANNELS];
int16_t imuData[6];
bool needToUpdateOutputs;
uint16_t rpyCorrections[3];
int16_t deadbands[3];
int centerCount;
float rateAverages[3];
int avgCount;

//PID variables used by all modes
float lastRollError;
float rollITerm;
float lastPitchError;
float pitchITerm;
float lastYawError;
float yawITerm;

bool rollIgnoreStick;
bool pitchIgnoreStick;
bool yawIgnoreStick;

static float normalBaseGains[3];
static float levelBaseGains[2];
static float lockBaseGains[3];
static int modeChannel;
static int rollGainChannel;
static int pitchGainChannel;
static int yawGainChannel;
static bool attitudeInitialized;
static bool doWiggle;
static int wiggleCount;
static int imuMissedCount;


FlightModeType decodeFlightMode(void);
void calculateGains(void);
void verifyAndSetOutputs(void);
void initPIDValues(void);

void gyroTask(void *pvParameters) {
    int16_t temp;
    FlightModeType newMode;
    portTASK_USES_FLOATING_POINT();
    attitudeInitialized = false;
    currentFlightMode = OFF_MODE;
    modeChannel = settings.flightModeChannel;
    if (settings.numFlightModes == 1) {
        modeChannel = 0;
    }
    rollGainChannel = settings.gainChannels[ROLL_INDEX];
    pitchGainChannel = settings.gainChannels[PITCH_INDEX];
    yawGainChannel = settings.gainChannels[YAW_INDEX];
    for (int i = 0; i < 3; ++i) {
        normalBaseGains[i] = settings.normalGains[i] / 100.0;
        lockBaseGains[i] = settings.lockGains[i] / 100.0;
        if (i < 2) {
            levelBaseGains[i] = settings.levelGains[i] / 100.0;
        }
    }
    rollGains[NORMAL_GAIN] = normalBaseGains[ROLL_INDEX];
    rollGains[LEVEL_GAIN] = levelBaseGains[ROLL_INDEX];
    rollGains[LOCK_GAIN] = lockBaseGains[ROLL_INDEX];
    pitchGains[NORMAL_GAIN] = normalBaseGains[PITCH_INDEX];
    pitchGains[LEVEL_GAIN] = levelBaseGains[PITCH_INDEX];
    pitchGains[LOCK_GAIN] = lockBaseGains[PITCH_INDEX];
    yawGains[NORMAL_GAIN] = normalBaseGains[YAW_INDEX];
    yawGains[LOCK_GAIN] = lockBaseGains[YAW_INDEX];
    yawGains[LEVEL_GAIN] = 0;
    deadbands[ROLL_INDEX] = (settings.deadbands[ROLL_INDEX] * 1024) / 100;
    deadbands[PITCH_INDEX] = (settings.deadbands[PITCH_INDEX] * 1024) / 100;
    deadbands[YAW_INDEX] = (settings.deadbands[YAW_INDEX] * 1024) / 100;
    needToUpdateOutputs = false;
    doWiggle = false;
    wiggleCount = CONTROL_LOOP_FREQ / 2;
    imuMissedCount = 0;
    centerCount = CENTER_COUNT;
    for (int i = 0; i < 3; ++i) {
        rateAverages[i] = 0;
    }
    avgCount = 0;
    rollIgnoreStick = false;
    pitchIgnoreStick = false;
    yawIgnoreStick = false;
    WDT_Enable();
    while (1) {
        if (xQueueReceive(imuQueue, imuData, 3) == pdTRUE) {
            imuMissedCount = 0;
            //Remap axis based on orientation
            switch (settings.gyroOrientation) {
                case FLAT_ORIENTATION:
                    imuData[IMU_ACCEL_X] = -imuData[IMU_ACCEL_X];
                    imuData[IMU_GYRO_Y] = -imuData[IMU_GYRO_Y];
                    imuData[IMU_ACCEL_Y] = -imuData[IMU_ACCEL_Y];
                    imuData[IMU_GYRO_X] = -imuData[IMU_GYRO_X];
                    break;
                case INVERTED_ORIENTATION:
                    imuData[IMU_ACCEL_Z] = -imuData[IMU_ACCEL_Z];
                    imuData[IMU_GYRO_Z] = -imuData[IMU_GYRO_Z];
                    imuData[IMU_ACCEL_X] = -imuData[IMU_ACCEL_X];
                    imuData[IMU_GYRO_X] = -imuData[IMU_GYRO_X];
                    break;
                case LEFT_DOWN_ORIENTATION:
                    imuData[IMU_ACCEL_X] = -imuData[IMU_ACCEL_X];
                    imuData[IMU_GYRO_X] = -imuData[IMU_GYRO_X];
                    temp = imuData[IMU_ACCEL_Y];
                    imuData[IMU_ACCEL_Y] = -imuData[IMU_ACCEL_Z];
                    imuData[IMU_ACCEL_Z] = -temp;
                    temp = imuData[IMU_GYRO_Z];
                    imuData[IMU_GYRO_Z] = -imuData[IMU_GYRO_Y];
                    imuData[IMU_GYRO_Y] = -temp;
                    break;
                case RIGHT_DOWN_ORIENTATION:
                    imuData[IMU_ACCEL_X] = -imuData[IMU_ACCEL_X];
                    imuData[IMU_GYRO_X] = -imuData[IMU_GYRO_X];
                    temp = imuData[IMU_ACCEL_Y];
                    imuData[IMU_ACCEL_Y] = imuData[IMU_ACCEL_Z];
                    imuData[IMU_ACCEL_Z] = temp;
                    temp = imuData[IMU_GYRO_Z];
                    imuData[IMU_GYRO_Z] = imuData[IMU_GYRO_Y];
                    imuData[IMU_GYRO_Y] = temp;
                    break;
            }
            if (!attitudeInitialized) {
                initAttitude();
                attitudeInitialized = true;
                if (startMode != START_WDTO) {
                    doWiggle = true;
                }
            }
            updateAttitude();
            rateAverages[ROLL_INDEX] += attitude.gyroRatesDeg.rollRate;
            rateAverages[PITCH_INDEX] += attitude.gyroRatesDeg.pitchRate;
            rateAverages[YAW_INDEX] += attitude.gyroRatesDeg.yawRate;
            ++avgCount;
        } else {
            if (attitudeInitialized) {
                ++imuMissedCount;
                if (imuMissedCount >= GYRO_ODR) {
                    attitudeInitialized = false;
                    vTaskSuspend(imuTaskHandle);
                }
            }
        }
        if (needToUpdateOutputs) {
            needToUpdateOutputs = false;
            rpyCorrections[AILERON_INDEX] = 0;
            rpyCorrections[ELEVATOR_INDEX] = 0;
            rpyCorrections[RUDDER_INDEX] = 0;
            for (int i = 0; i < 3; ++i) {
                rateAverages[i] /= (float) avgCount;
            }
            newMode = decodeFlightMode();
            if (attitudeInitialized && newMode != currentFlightMode) {
                currentFlightMode = newMode;
                initPIDValues();
                rollIgnoreStick = false;
                pitchIgnoreStick = false;
                yawIgnoreStick = false;
                switch (currentFlightMode) {
                    case NORMAL_MODE:
                        initNormalMode();
                        break;
                    case AUTO_LEVEL_MODE:
                        initAutoLevel();
                        initNormalMode();
                        break;
                    case LAUNCH_ASSIST_MODE:
                        initLaunchAssist();
                        initAutoLevel();
                        initNormalMode();
                        break;
                    case ATTITUDE_LOCK_MODE:
                        initAttitudeLock();
                        break;
                    case TRAINER_MODE:
                        initTrainerMode();
                        initNormalMode();
                        break;
                    case ANGLE_MODE:
                        initAngleMode();
                        break;
                    case CUSTOM_MODE_1:
                    case CUSTOM_MODE_2:
                        initLaunchAssist();
                        initAutoLevel();
                        initNormalMode();
                        initTrainerMode();
                        initAttitudeLock();
                        initAngleMode();
                        break;
                    default:
                        break;
                }
            }
            calculateGains();
            if (doWiggle) {
                rpyCorrections[AILERON_INDEX] = 0;
                rpyCorrections[ELEVATOR_INDEX] = 0;
                rpyCorrections[RUDDER_INDEX] = 0;
                if (wiggleCount > 2 * CONTROL_LOOP_FREQ / 6) {
                    if (settings.gyroEnabledFlags & AILERON_MASK) {
                        rpyCorrections[AILERON_INDEX] = 300;
                    }
                    if (settings.gyroEnabledFlags & ELEVATOR_MASK) {
                        rpyCorrections[ELEVATOR_INDEX] = 300;
                    }
                    if (settings.gyroEnabledFlags & RUDDER_MASK) {
                        rpyCorrections[RUDDER_INDEX] = 300;
                    }
                } else if (wiggleCount > CONTROL_LOOP_FREQ / 6) {
                    if (settings.gyroEnabledFlags & AILERON_MASK) {
                        rpyCorrections[AILERON_INDEX] = -300;
                    }
                    if (settings.gyroEnabledFlags & ELEVATOR_MASK) {
                        rpyCorrections[ELEVATOR_INDEX] = -300;
                    }
                    if (settings.gyroEnabledFlags & RUDDER_MASK) {
                        rpyCorrections[RUDDER_INDEX] = -300;
                    }
                } else if (wiggleCount > 0) {
                    rpyCorrections[AILERON_INDEX] = 0;
                    rpyCorrections[ELEVATOR_INDEX] = 0;
                    rpyCorrections[RUDDER_INDEX] = 0;
                } else {
                    doWiggle = false;
                }
                if (wiggleCount != 0) {
                    --wiggleCount;
                }
                verifyAndSetOutputs();
            } else if (currentFlightMode == OFF_MODE || !attitudeInitialized) {
                outputServos[throttleChannel] = rawServoPositions[throttleChannel];
                if (settings.wingType == ELEVON_A || settings.wingType == ELEVON_B) {
                    int16_t newAileron = rawServoPositions[aileronChannel];
                    int16_t newElevator = rawServoPositions[elevatorChannel];
                    newAileron -= channelCenters[aileronChannel];
                    newElevator -= channelCenters[elevatorChannel];
                    if (settings.wingType == ELEVON_A) {
                        outputServos[aileronChannel] = 1024 + (newElevator + newAileron) / 2;
                        outputServos[elevatorChannel] = 1024 + (newElevator - newAileron) / 2;
                    } else {
                        outputServos[aileronChannel] = 1024 + (-newElevator + newAileron) / 2;
                        outputServos[elevatorChannel] = 1024 + (newElevator + newAileron) / 2;
                    }
                } else {
                    outputServos[aileronChannel] = rawServoPositions[aileronChannel];
                    outputServos[elevatorChannel] = rawServoPositions[elevatorChannel];
                }
                for (int i = RUDDER; i < MAX_CHANNELS; ++i) {
                    outputServos[i] = rawServoPositions[i];
                }
            } else { //We have an active flight mode
                if (currentFlightMode == NORMAL_MODE) {
                    normalModeCalculate(ROLL_AXIS | PITCH_AXIS | YAW_AXIS);
                } else if (currentFlightMode == AUTO_LEVEL_MODE) {
                    autoLevelCalculate(ROLL_AXIS | PITCH_AXIS);
                    normalModeCalculate(YAW_AXIS);
                } else if (currentFlightMode == ATTITUDE_LOCK_MODE) {
                    attitudeLockCalculate(ROLL_AXIS | PITCH_AXIS | YAW_AXIS);
                } else if (currentFlightMode == LAUNCH_ASSIST_MODE) {
                    autoLevelCalculate(ROLL_AXIS);
                    launchAssistCalculate(PITCH_AXIS);
                    normalModeCalculate(YAW_AXIS);
                } else if (currentFlightMode == TRAINER_MODE) {
                    trainerModeCalculate(ROLL_AXIS | PITCH_AXIS);
                    normalModeCalculate(YAW_AXIS);
                } else if (currentFlightMode == ANGLE_MODE) {
                    angleModeCalculate(ROLL_AXIS | PITCH_AXIS | YAW_AXIS);
                } else if (currentFlightMode == CUSTOM_MODE_1 || currentFlightMode == CUSTOM_MODE_2) {
                    CustomModeType *mode;
                    if (currentFlightMode == CUSTOM_MODE_1) {
                        mode = &settings.customMode1;
                    } else if (currentFlightMode == CUSTOM_MODE_2) {
                        mode = &settings.customMode2;
                    }
                    switch (mode->aileronMode) {
                        case NORMAL_MODE:
                            normalModeCalculate(ROLL_AXIS);
                            break;
                        case AUTO_LEVEL_MODE:
                        case LAUNCH_ASSIST_MODE:
                            autoLevelCalculate(ROLL_AXIS);
                            break;
                        case ATTITUDE_LOCK_MODE:
                            attitudeLockCalculate(ROLL_AXIS);
                            break;
                        case TRAINER_MODE:
                            trainerModeCalculate(ROLL_AXIS);
                            break;
                        case ANGLE_MODE:
                            angleModeCalculate(ROLL_AXIS);
                            break;
                        case OFF_MODE:
                            rpyCorrections[AILERON_INDEX] = 0;
                            break;
                    }
                    switch (mode->elevatorMode) {
                        case NORMAL_MODE:
                            normalModeCalculate(PITCH_AXIS);
                            break;
                        case AUTO_LEVEL_MODE:
                            autoLevelCalculate(PITCH_AXIS);
                            break;
                        case LAUNCH_ASSIST_MODE:
                            launchAssistCalculate(PITCH_AXIS);
                            break;
                        case ATTITUDE_LOCK_MODE:
                            attitudeLockCalculate(PITCH_AXIS);
                            break;
                        case TRAINER_MODE:
                            trainerModeCalculate(PITCH_AXIS);
                            break;
                        case ANGLE_MODE:
                            angleModeCalculate(PITCH_AXIS);
                            break;
                        case OFF_MODE:
                            rpyCorrections[ELEVATOR_INDEX] = 0;
                            break;
                    }
                    switch (mode->rudderMode) {
                        case NORMAL_MODE:
                        case AUTO_LEVEL_MODE:
                        case LAUNCH_ASSIST_MODE:
                        case TRAINER_MODE:
                            normalModeCalculate(YAW_AXIS);
                            break;
                        case ATTITUDE_LOCK_MODE:
                            attitudeLockCalculate(YAW_AXIS);
                            break;
                        case ANGLE_MODE:
                            angleModeCalculate(YAW_AXIS);
                            break;
                        case OFF_MODE:
                            rpyCorrections[RUDDER_INDEX] = 0;
                            break;
                    }
                }
                verifyAndSetOutputs();
            }
            for (int i = 0; i < 3; ++i) {
                rateAverages[i] = 0.0;
            }
            avgCount = 0;
            WDT_Clear();
        }
    }
}

FlightModeType decodeFlightMode(void) {
    if (modeChannel == 0 || settings.numFlightModes == 1) {
        return settings.flightModes[0];
    } else {
        uint16_t value = rawServoPositions[modeChannel];
        if (value == 0xffff) {
            return OFF_MODE;
        }
        if (settings.numFlightModes == 3) {
            if (value < 682) {
                return settings.flightModes[0];
            }
            if (value < 1364) {
                return settings.flightModes[1];
            }
            return settings.flightModes[2];
        } else { //6 modes
            if (value < 341) {
                return settings.flightModes[0];
            }
            if (value < 682) {
                return settings.flightModes[1];
            }
            if (value < 1024) {
                return settings.flightModes[2];
            }
            if (value < 1364) {
                return settings.flightModes[3];
            }
            if (value < 1705) {
                return settings.flightModes[4];
            }
            return settings.flightModes[5];
        }
    }
}

void calculateGains(void) {
    float gainAdjust;
    if (rollGainChannel) {
        gainAdjust = rawServoPositions[rollGainChannel] / 2047.0;
        rollGains[NORMAL_GAIN] = normalBaseGains[ROLL_INDEX] * gainAdjust;
        rollGains[LEVEL_GAIN] = levelBaseGains[ROLL_INDEX] * gainAdjust;
        rollGains[LOCK_GAIN] = lockBaseGains[ROLL_INDEX] * gainAdjust;
    }
    if (pitchGainChannel) {
        gainAdjust = rawServoPositions[pitchGainChannel] / 2047.0;
        pitchGains[NORMAL_GAIN] = normalBaseGains[PITCH_INDEX] * gainAdjust;
        pitchGains[LEVEL_GAIN] = levelBaseGains[PITCH_INDEX] * gainAdjust;
        pitchGains[LOCK_GAIN] = lockBaseGains[PITCH_INDEX] * gainAdjust;
    }
    if (yawGainChannel) {
        gainAdjust = rawServoPositions[yawGainChannel] / 2047.0;
        yawGains[NORMAL_GAIN] = normalBaseGains[YAW_INDEX] * gainAdjust;
        yawGains[LOCK_GAIN] = lockBaseGains[YAW_INDEX] * gainAdjust;
    }
}

void verifyAndSetOutputs(void) {
    int16_t newServoPosition;
    int16_t newServo2Position;
    int16_t newAileron;
    int16_t newElevator;
    if (settings.wingType == ELEVON_A || settings.wingType == ELEVON_B) {
        if (settings.gyroEnabledFlags & AILERON_MASK) {
            if (rollIgnoreStick) {
                newAileron = channelCenters[aileronChannel];
            } else {
                newAileron = rawServoPositions[aileronChannel];
            }
            if (settings.gyroReverseFlags & AILERON_MASK) {
                newAileron -= rpyCorrections[AILERON_INDEX];
            } else {
                newAileron += rpyCorrections[AILERON_INDEX];
            }
        } else {
            newAileron = rawServoPositions[aileronChannel];
        }
        if (settings.gyroEnabledFlags & ELEVATOR_MASK) {
            if (rollIgnoreStick) {
                newElevator = channelCenters[elevatorChannel];
            } else {
                newElevator = rawServoPositions[elevatorChannel];
            }
            if (settings.gyroReverseFlags & ELEVATOR_MASK) {
                newElevator -= rpyCorrections[ELEVATOR_INDEX];
            } else {
                newElevator += rpyCorrections[ELEVATOR_INDEX];
            }
        } else {
            newElevator = rawServoPositions[elevatorChannel];
        }
        newAileron -= channelCenters[aileronChannel];
        newElevator -= channelCenters[elevatorChannel];
        if (settings.wingType == ELEVON_A) {
            newServoPosition = 1024 + (newElevator + newAileron) / 2;
            newServo2Position = 1024 + (newElevator - newAileron) / 2;
        } else { //ELEVON_B
            newServoPosition = 1024 + (newAileron - newElevator) / 2;
            newServo2Position = 1024 + (newAileron + newElevator) / 2;
        }
        if (newServoPosition < settings.minTravelLimits[AILERON_INDEX]) {
            newServoPosition = settings.minTravelLimits[AILERON_INDEX];
        } else if (newServoPosition > settings.maxTravelLimits[AILERON_INDEX]) {
            newServoPosition = settings.maxTravelLimits[AILERON_INDEX];
        }
        if (newServo2Position < settings.minTravelLimits[ELEVATOR_INDEX]) {
            newServo2Position = settings.minTravelLimits[ELEVATOR_INDEX];
        } else if (newServo2Position > settings.maxTravelLimits[ELEVATOR_INDEX]) {
            newServo2Position = settings.maxTravelLimits[ELEVATOR_INDEX];
        }
        outputServos[aileronChannel] = newServoPosition;
        outputServos[elevatorChannel] = newServo2Position;
    } else { //Normal wing with 1 or 2 aileron and 1 or 2 elevator
        if (settings.gyroEnabledFlags & AILERON_MASK) {
            if (rollIgnoreStick) {
                newServoPosition = channelCenters[aileronChannel];
            } else {
                newServoPosition = rawServoPositions[aileronChannel];
            }
            if (settings.gyroReverseFlags & AILERON_MASK) {
                newServoPosition -= rpyCorrections[AILERON_INDEX];
            } else {
                newServoPosition += rpyCorrections[AILERON_INDEX];
            }
            if (newServoPosition < settings.minTravelLimits[AILERON_INDEX]) {
                newServoPosition = settings.minTravelLimits[AILERON_INDEX];
            } else if (newServoPosition > settings.maxTravelLimits[AILERON_INDEX]) {
                newServoPosition = settings.maxTravelLimits[AILERON_INDEX];
            }
            outputServos[aileronChannel] = newServoPosition;
        } else {
            outputServos[aileronChannel] = rawServoPositions[aileronChannel];
        }
        if (settings.gyroEnabledFlags & ELEVATOR_MASK) {
            if (rollIgnoreStick) {
                newServoPosition = channelCenters[elevatorChannel];
            } else {
                newServoPosition = rawServoPositions[elevatorChannel];
            }
            if (settings.gyroReverseFlags & ELEVATOR_MASK) {
                newServoPosition -= rpyCorrections[ELEVATOR_INDEX];
            } else {
                newServoPosition += rpyCorrections[ELEVATOR_INDEX];
            }
            if (newServoPosition < settings.minTravelLimits[ELEVATOR_INDEX]) {
                newServoPosition = settings.minTravelLimits[ELEVATOR_INDEX];
            } else if (newServoPosition > settings.maxTravelLimits[ELEVATOR_INDEX]) {
                newServoPosition = settings.maxTravelLimits[ELEVATOR_INDEX];
            }
            outputServos[elevatorChannel] = newServoPosition;
        } else {
            outputServos[elevatorChannel] = rawServoPositions[elevatorChannel];
        }
        if (settings.gyroEnabledFlags & AILERON2_MASK) {
            if (rollIgnoreStick) {
                newServoPosition = channelCenters[settings.aileron2Channel];
            } else {
                newServoPosition = rawServoPositions[settings.aileron2Channel];
            }
            if (settings.gyroReverseFlags & AILERON2_MASK) {
                newServoPosition += rpyCorrections[AILERON_INDEX];
            } else {
                newServoPosition -= rpyCorrections[AILERON_INDEX];
            }
            if (newServoPosition < settings.minTravelLimits[AILERON2_INDEX]) {
                newServoPosition = settings.minTravelLimits[AILERON2_INDEX];
            } else if (newServoPosition > settings.maxTravelLimits[AILERON2_INDEX]) {
                newServoPosition = settings.maxTravelLimits[AILERON2_INDEX];
            }
            outputServos[settings.aileron2Channel] = newServoPosition;
        }
        if (settings.gyroEnabledFlags & ELEVATOR2_MASK) {
            if (pitchIgnoreStick) {
                newServoPosition = channelCenters[settings.elevator2Channel];
            } else {
                newServoPosition = rawServoPositions[settings.elevator2Channel];
            }
            if (settings.gyroReverseFlags & ELEVATOR2_MASK) {
                newServoPosition -= rpyCorrections[ELEVATOR_INDEX];
            } else {
                newServoPosition += rpyCorrections[ELEVATOR_INDEX];
            }
            if (newServoPosition < settings.minTravelLimits[ELEVATOR2_INDEX]) {
                newServoPosition = settings.minTravelLimits[ELEVATOR2_INDEX];
            } else if (newServoPosition > settings.maxTravelLimits[ELEVATOR2_INDEX]) {
                newServoPosition = settings.maxTravelLimits[ELEVATOR2_INDEX];
            }
            outputServos[settings.elevator2Channel] = newServoPosition;
        }
    }
    if (settings.gyroEnabledFlags & RUDDER_MASK) {
        if (yawIgnoreStick) {
            newServoPosition = channelCenters[RUDDER];
        } else {
            newServoPosition = rawServoPositions[RUDDER];
        }
        if (settings.gyroReverseFlags & RUDDER_MASK) {
            newServoPosition -= rpyCorrections[RUDDER_INDEX];
        } else {
            newServoPosition += rpyCorrections[RUDDER_INDEX];
        }
        if (newServoPosition < settings.minTravelLimits[RUDDER_INDEX]) {
            newServoPosition = settings.minTravelLimits[RUDDER_INDEX];
        } else if (newServoPosition > settings.maxTravelLimits[RUDDER_INDEX]) {
            newServoPosition = settings.maxTravelLimits[RUDDER_INDEX];
        }
        outputServos[RUDDER] = newServoPosition;
    } else {
        outputServos[RUDDER] = rawServoPositions[RUDDER];
    }
    outputServos[throttleChannel] = rawServoPositions[throttleChannel];
    //All managed channels have there outputs set so the rest need to be done
    // Aileron2 and Elevator2 should be skipped if enabled as they are done
    for (int i = RUDDER + 1; i < MAX_CHANNELS; ++i) {
        if ((settings.gyroEnabledFlags & AILERON2_MASK) && (i == settings.aileron2Channel)) {
            continue;
        } else if ((settings.gyroEnabledFlags & ELEVATOR2_MASK) && (i == settings.elevator2Channel)) {
            continue;
        } else {
            outputServos[i] = rawServoPositions[i];
        }
    }
}

bool sticksCentered(void) {
    if (abs(rawServoPositions[aileronChannel] - channelCenters[aileronChannel]) < deadbands[ROLL_INDEX]
            && abs(rawServoPositions[elevatorChannel] - channelCenters[elevatorChannel]) < deadbands[PITCH_INDEX]) {
        if (centerCount > 0) {
            --centerCount;
        } else {
            return true;
        }
    } else {
        centerCount = CENTER_COUNT;
    }
    return false;
}

void initPIDValues(void) {
    lastRollError = 0;
    rollITerm = 0;
    lastPitchError = 0;
    pitchITerm = 0;
    lastYawError = 0;
    yawITerm = 0;
}
