bemcgarvey/RX12G/firmware/src/trainer.c

/////////////////////////////////////////////////////
// Project: RX12G                                  //
// File: trainer.c                                 //
// Target: PIC32MK1024GPK064                       // 
// Compiler: XC32                                  //
// Author: Brad McGarvey                           //
// License: GNU General Public License v3.0        //
// Description: trainer mode                       //
/////////////////////////////////////////////////////

#include "definitions.h"
#include "autoLevel.h"
#include "gyroTask.h"
#include "attitude.h"
#include "trainer.h"
#include "rxTask.h"
#include "settings.h"

static float rollScale;
static float pitchScale;

void initTrainerMode(void) {
    float maxRange;
    float minRange;
    maxRange = settings.maxTravelLimits[AILERON_INDEX] - channelCenters[aileronChannel];
    minRange = channelCenters[aileronChannel] - settings.minTravelLimits[AILERON_INDEX];
    if (maxRange < minRange) {
        rollScale = settings.rollLimit / maxRange;
    } else {
        rollScale = settings.rollLimit / minRange;
    }
    if (settings.gyroReverseFlags & AILERON_MASK) {
        rollScale = -rollScale;
    }
    maxRange = settings.maxTravelLimits[ELEVATOR_INDEX] - channelCenters[elevatorChannel];
    minRange = channelCenters[elevatorChannel] - settings.minTravelLimits[ELEVATOR_INDEX];
    if (maxRange < minRange) {
        pitchScale = settings.pitchLimit / maxRange;
    } else {
        pitchScale = settings.pitchLimit / minRange;
    }
    if (settings.gyroReverseFlags & ELEVATOR_MASK) {
        pitchScale = -pitchScale;
    }
}

void trainerModeCalculate(int axes) {
    float error;
    float deltaError;
    float target;
    float gain;
    
    if (axes & ROLL_AXIS) {
        rollIgnoreStick = true;
        target = (rawServoPositions[aileronChannel] - channelCenters[aileronChannel]) * rollScale;
        if (target > settings.rollLimit) {
            target = settings.rollLimit;
        } else if (target < -settings.rollLimit) {
            target = -settings.rollLimit;
        }
        error = target - attitude.ypr.roll;
        deltaError = error - lastRollError;
        lastRollError = error;
        rollITerm += error;
        if (rollITerm > settings.rollPID._maxI) {
            rollITerm = settings.rollPID._maxI;
        } else if (rollITerm < -settings.rollPID._maxI) {
            rollITerm = -settings.rollPID._maxI;
        }
        if (rollGains[LEVEL_GAIN] > MIN_GAIN) {
            gain = rollGains[LEVEL_GAIN];
        } else {
            gain = MIN_GAIN;
        }
        rpyCorrections[ROLL_INDEX] = (error * settings.rollPID._P
                + rollITerm * settings.rollPID._I
                + deltaError * settings.rollPID._D) * gain;
    }
    if (axes & PITCH_AXIS) {
        pitchIgnoreStick = true;
        target = (rawServoPositions[elevatorChannel] - channelCenters[elevatorChannel]) * pitchScale;
        if (target > settings.pitchLimit) {
            target = settings.pitchLimit;
        } else if (target < -settings.pitchLimit) {
            target = -settings.pitchLimit;
        }
        error = target - attitude.ypr.pitch;
        deltaError = error - lastPitchError;
        lastPitchError = error;
        pitchITerm += error;
        if (pitchITerm > settings.pitchPID._maxI) {
            pitchITerm = settings.pitchPID._maxI;
        } else if (pitchITerm < -settings.pitchPID._maxI) {
            pitchITerm = -settings.pitchPID._maxI;
        }
        if (pitchGains[LEVEL_GAIN] > MIN_GAIN) {
            gain = pitchGains[LEVEL_GAIN];
        } else {
            gain = MIN_GAIN;
        }
        rpyCorrections[PITCH_INDEX] = (error * settings.pitchPID._P
                + pitchITerm * settings.pitchPID._I
                + deltaError * settings.pitchPID._D) * gain;
    }
}
