bemcgarvey/RX12G/firmware/src/config/default/initialization.c

/*******************************************************************************
  System Initialization File

  File Name:
    initialization.c

  Summary:
    This file contains source code necessary to initialize the system.

  Description:
    This file contains source code necessary to initialize the system.  It
    implements the "SYS_Initialize" function, defines the configuration bits,
    and allocates any necessary global system resources,
 *******************************************************************************/

// DOM-IGNORE-BEGIN
/*******************************************************************************
* Copyright (C) 2018 Microchip Technology Inc. and its subsidiaries.
*
* Subject to your compliance with these terms, you may use Microchip software
* and any derivatives exclusively with Microchip products. It is your
* responsibility to comply with third party license terms applicable to your
* use of third party software (including open source software) that may
* accompany Microchip software.
*
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
* IN NO EVENT WILL MICROCHIP BE LIABLE FOR ANY INDIRECT, SPECIAL, PUNITIVE,
* INCIDENTAL OR CONSEQUENTIAL LOSS, DAMAGE, COST OR EXPENSE OF ANY KIND
* WHATSOEVER RELATED TO THE SOFTWARE, HOWEVER CAUSED, EVEN IF MICROCHIP HAS
* BEEN ADVISED OF THE POSSIBILITY OR THE DAMAGES ARE FORESEEABLE. TO THE
* FULLEST EXTENT ALLOWED BY LAW, MICROCHIP'S TOTAL LIABILITY ON ALL CLAIMS IN
* ANY WAY RELATED TO THIS SOFTWARE WILL NOT EXCEED THE AMOUNT OF FEES, IF ANY,
* THAT YOU HAVE PAID DIRECTLY TO MICROCHIP FOR THIS SOFTWARE.
 *******************************************************************************/
// DOM-IGNORE-END

// *****************************************************************************
// *****************************************************************************
// Section: Included Files
// *****************************************************************************
// *****************************************************************************
#include "configuration.h"
#include "definitions.h"
#include "device.h"



// ****************************************************************************
// ****************************************************************************
// Section: Configuration Bits
// ****************************************************************************
// ****************************************************************************

/*** DEVCFG0 ***/
#pragma config DEBUG =      OFF
#pragma config JTAGEN =     OFF
#pragma config ICESEL =     ICS_PGx1
#pragma config TRCEN =      OFF
#pragma config BOOTISA =    MIPS32
#pragma config FSLEEP =     OFF
#pragma config DBGPER =     PG_ALL
#pragma config SMCLR =      MCLR_NORM
#pragma config SOSCGAIN =   G3
#pragma config SOSCBOOST =  ON
#pragma config POSCGAIN =   G3
#pragma config POSCBOOST =  ON
#pragma config POSCAGC = Manual
#pragma config EJTAGBEN =   NORMAL

/*** DEVCFG1 ***/
#pragma config FNOSC =      SPLL
#pragma config DMTINTV =    WIN_127_128
#pragma config FSOSCEN =    OFF
#pragma config IESO =       OFF
#pragma config POSCMOD =    EC
#pragma config OSCIOFNC =   OFF
#pragma config FCKSM =      CSECME
#pragma config WDTPS =      PS32
#pragma config WDTSPGM =    STOP
#pragma config FWDTEN =     OFF
#pragma config WINDIS =     NORMAL
#pragma config FWDTWINSZ =  WINSZ_25
#pragma config DMTCNT =     DMT31
#pragma config FDMTEN =     OFF

/*** DEVCFG2 ***/
#pragma config FPLLIDIV =   DIV_1
#pragma config FPLLRNG =    RANGE_13_26_MHZ
#pragma config FPLLICLK =   PLL_POSC
#pragma config FPLLMULT =   MUL_20
#pragma config FPLLODIV =   DIV_4
#pragma config BORSEL =     HIGH
#pragma config UPLLEN =     ON

/*** DEVCFG3 ***/
#pragma config USERID =     0xffff
#pragma config FUSBIDIO2 =   OFF
#pragma config FVBUSIO2 =  OFF
#pragma config PGL1WAY =    ON
#pragma config PMDL1WAY =   ON
#pragma config IOL1WAY =    ON
#pragma config FUSBIDIO1 =   OFF
#pragma config FVBUSIO1 =  OFF

/*** BF1SEQ ***/
#pragma config TSEQ =       0x0
#pragma config CSEQ =       0xffff





// *****************************************************************************
// *****************************************************************************
// Section: Driver Initialization Data
// *****************************************************************************
// *****************************************************************************


// *****************************************************************************
// *****************************************************************************
// Section: System Data
// *****************************************************************************
// *****************************************************************************
/* Structure to hold the object handles for the modules in the system. */
SYSTEM_OBJECTS sysObj;

// *****************************************************************************
// *****************************************************************************
// Section: Library/Stack Initialization Data
// *****************************************************************************
// *****************************************************************************
/******************************************************
 * USB Driver Initialization
 ******************************************************/
 

uint8_t __attribute__((aligned(512))) endPointTable0[DRV_USBFS_ENDPOINTS_NUMBER * 32];


const DRV_USBFS_INIT drvUSBFSInit0 =
{
	 /* Assign the endpoint table */
    .endpointTable= endPointTable0,
	/* Interrupt Source for USB module */
	.interruptSource = INT_SOURCE_USB_1 ,
   
    /* USB Controller to operate as USB Device */
    .operationMode = DRV_USBFS_OPMODE_DEVICE,
	
	.operationSpeed = USB_SPEED_FULL,
 
	/* Stop in idle */
    .stopInIdle = false,
	
	    /* Suspend in sleep */
    .suspendInSleep = false,
    /* Identifies peripheral (PLIB-level) ID */
    .usbID = USB_ID_1,
	

};








// *****************************************************************************
// *****************************************************************************
// Section: System Initialization
// *****************************************************************************
// *****************************************************************************



// *****************************************************************************
// *****************************************************************************
// Section: Local initialization functions
// *****************************************************************************
// *****************************************************************************



/*******************************************************************************
  Function:
    void SYS_Initialize ( void *data )

  Summary:
    Initializes the board, services, drivers, application and other modules.

  Remarks:
 */

void SYS_Initialize ( void* data )
{

    /* Start out with interrupts disabled before configuring any modules */
    __builtin_disable_interrupts();

  
    CLK_Initialize();

    /* Configure CP0.K0 for optimal performance (cached instruction pre-fetch) */
    __builtin_mtc0(16, 0,(__builtin_mfc0(16, 0) | 0x3));

    /* Configure Wait States and Prefetch */
    CHECONbits.PFMWS = 2;
    CHECONbits.PREFEN = 1;



	GPIO_Initialize();
    
    DMAC_Initialize();

    CORETIMER_Initialize();
    TMR6_Initialize();
        
    I2C2_Initialize();

    TMR7_Initialize();

    TMR5_Initialize();

    EEPROM_Initialize();
        
    TMR2_Initialize();

    TMR8_Initialize();

    TMR9_Initialize();





	 /* Initialize the USB device layer */
    sysObj.usbDevObject0 = USB_DEVICE_Initialize (USB_DEVICE_INDEX_0 , ( SYS_MODULE_INIT* ) & usbDevInitData0);
	
	

	/* Initialize USB Driver */ 
    sysObj.drvUSBFSObject0 = DRV_USBFS_Initialize(DRV_USBFS_INDEX_0, (SYS_MODULE_INIT *) &drvUSBFSInit0);	


    EVIC_Initialize();

	/* Enable global interrupts */
    __builtin_enable_interrupts();


}


/*******************************************************************************
 End of File
*/
