bemcgarvey/RX12G/firmware/src/crsfTelemetryTask.h

/////////////////////////////////////////////////////
// Project: RX12G                                  //
// File: crsfTelemetryTask.h                       //
// Target: PIC32MK1024GPK064                       // 
// Compiler: XC32                                  //
// Author: Brad McGarvey                           //
// License: GNU General Public License v3.0        //
// Description: ExpressLRS telemetry               //
/////////////////////////////////////////////////////

#ifndef CRSFTELEMETRYTASK_H
#define	CRSFTELEMETRYTASK_H

#ifdef	__cplusplus
extern "C" {
#endif

void crsfTelemetryTask(void *pvParameters);

#ifdef	__cplusplus
}
#endif

#endif	/* CRSFTELEMETRYTASK_H */
