bemcgarvey/RX12G/firmware/src/version.h

/////////////////////////////////////////////////////
// Project: RX12G                                  //
// File: version.h                                 //
// Target: PIC32MK1024GPK064                       // 
// Compiler: XC32                                  //
// Author: Brad McGarvey                           //
// License: GNU General Public License v3.0        //
// Description: firmware version                   //
/////////////////////////////////////////////////////

#ifndef VERSION_H
#define	VERSION_H

#ifdef	__cplusplus
extern "C" {
#endif

#define MAJOR_VERSION   1
#define MINOR_VERSION   2
    
    extern const unsigned int firmwareVersion;


#ifdef	__cplusplus
}
#endif

#endif	/* VERSION_H */
