bemcgarvey/RX12G/firmware/src/usbapp.h

/////////////////////////////////////////////////////
// Project: RX12G                                  //
// File: usbapp.h                                  //
// Target: PIC32MK1024GPK064                       // 
// Compiler: XC32                                  //
// Author: Brad McGarvey                           //
// License: GNU General Public License v3.0        //
// Description: USB state machine and commands     //
/////////////////////////////////////////////////////

#ifndef USBAPP_H
#define USBAPP_H

#ifdef	__cplusplus
extern "C" {
#endif

void USBAppTasks (void *pvParameters);

#ifdef	__cplusplus
}
#endif

#endif 
