bemcgarvey/RX12G/firmware/src/gyroTask.h

/////////////////////////////////////////////////////
// Project: RX12G                                  //
// File: gyroTask.h                                //
// Target: PIC32MK1024GPK064                       // 
// Compiler: XC32                                  //
// Author: Brad McGarvey                           //
// License: GNU General Public License v3.0        //
// Description: gyro and stability code            //
/////////////////////////////////////////////////////

#ifndef GYROTASK_H
#define	GYROTASK_H

#include "settings.h"

#ifdef	__cplusplus
extern "C" {
#endif

#define CONTROL_LOOP_FREQ       50    //50Hz, 20ms control loop
#define CONTROL_LOOP_PERIOD     20
    
#define CENTER_COUNT    (CONTROL_LOOP_FREQ / 4)
    //IMU data indices 
#define IMU_GYRO_X      0
#define IMU_GYRO_Y      1
#define IMU_GYRO_Z      2
#define IMU_ACCEL_X      3
#define IMU_ACCEL_Y      4
#define IMU_ACCEL_Z      5
    
    enum {NORMAL_GAIN = 0, LEVEL_GAIN = 1, LOCK_GAIN = 2};
    extern FlightModeType currentFlightMode;
    extern volatile uint16_t rawServoPositions[MAX_CHANNELS];
    extern float rollGains[3];
    extern float pitchGains[3];
    extern float yawGains[3];
    extern uint16_t rpyCorrections[3];
    extern bool needToUpdateOutputs;
    extern int16_t deadbands[3];
    extern int centerCount;
    extern float rateAverages[3];
    extern int avgCount;
    extern int16_t imuData[6];
    extern float lastRollError;
    extern float rollITerm;
    extern float lastPitchError;
    extern float pitchITerm;
    extern float lastYawError;
    extern float yawITerm;
    extern bool rollIgnoreStick;
    extern bool pitchIgnoreStick;
    extern bool yawIgnoreStick;

    void gyroTask(void *pvParameters);
    bool sticksCentered(void);

    enum {
        ROLL_AXIS = 0x01, PITCH_AXIS = 0x02, YAW_AXIS = 0x04
    };

#ifdef	__cplusplus
}
#endif

#endif	/* GYROTASK_H */
