bemcgarvey/RX12G/firmware/src/usbBindTask.h

/////////////////////////////////////////////////////
// Project: RX12G                                  //
// File: uabBindTask.h                             //
// Target: PIC32MK1024GPK064                       // 
// Compiler: XC32                                  //
// Author: Brad McGarvey                           //
// License: GNU General Public License v3.0        //
// Description: bind from usb task                 //
/////////////////////////////////////////////////////

#ifndef USBBINDTASK_H
#define	USBBINDTASK_H

#ifdef	__cplusplus
extern "C" {
#endif

void usbBindTask(void *pvParameters);


#ifdef	__cplusplus
}
#endif

#endif	/* USBBINDTASK_H */
