bemcgarvey/RX12G/firmware/src/detectUSBTask.h

/////////////////////////////////////////////////////
// Project: RX12G                                  //
// File: detectUSBTask.h                           //
// Target: PIC32MK1024GPK064                       // 
// Compiler: XC32                                  //
// Author: Brad McGarvey                           //
// License: GNU General Public License v3.0        //
// Description: check for USB connect              //
/////////////////////////////////////////////////////

#ifndef DETECTUSBTASK_H
#define	DETECTUSBTASK_H

#ifdef	__cplusplus
extern "C" {
#endif

void detectUSBTask(void *pvParameters);


#ifdef	__cplusplus
}
#endif

#endif	/* DETECTUSBTASK_H */
