bemcgarvey/RX12G/firmware/src/buttonTask.c

/////////////////////////////////////////////////////
// Project: RX12G                                  //
// File: buttonTask.c                              //
// Target: PIC32MK1024GPK064                       // 
// Compiler: XC32                                  //
// Author: Brad McGarvey                           //
// License: GNU General Public License v3.0        //
// Description: bind button rtos task              //
/////////////////////////////////////////////////////

#include "definitions.h"
#include "buttonTask.h"
#include "rtosHandles.h"
#include "satellites.h"
#include "uart.h"

volatile bool isBinding = false;
TaskHandle_t buttonTaskHandle;

void buttonHandler(EXTERNAL_INT_PIN pin, uintptr_t context) {
    BaseType_t xHigherPriorityTaskWoken = pdFALSE;
    vTaskNotifyGiveFromISR(buttonTaskHandle, &xHigherPriorityTaskWoken);
    portEND_SWITCHING_ISR(xHigherPriorityTaskWoken);
}

void buttonTask(void *pvParameters) {
    int wdtState;
    EVIC_ExternalInterruptCallbackRegister(EXTERNAL_INT_3, buttonHandler, 0);
    EVIC_ExternalInterruptEnable(EXTERNAL_INT_3);
    while (1) {
        ulTaskNotifyTake(pdTRUE, portMAX_DELAY);
        wdtState = WDTCONbits.ON;
        WDT_Disable();
        vTaskDelay(2000);
        if (BIND_BUTTON_Get() == 0) {
            isBinding = true;
            bindSats();
            while (isBinding) {
                int n = ulTaskNotifyTake(pdTRUE, 100);
                if (n) {
                    vTaskDelay(20);
                    if (BIND_BUTTON_Get() == 0) {
                        satPowerOn(false);
                        vTaskDelay(500);
                        satPowerOn(true);
                        isBinding = false;
                    }
                }
                if (validPacketReceived) {
                    isBinding = false;
                }
            }
        }
        if (wdtState == 1) {
            WDT_Enable();
        }
    }
}
