bemcgarvey/RX12G/firmware/src/rxTask.h

/////////////////////////////////////////////////////
// Project: RX12G                                  //
// File: rxTask.h                                  //
// Target: PIC32MK1024GPK064                       // 
// Compiler: XC32                                  //
// Author: Brad McGarvey                           //
// License: GNU General Public License v3.0        //
// Description: packet rx rtos task                //
/////////////////////////////////////////////////////

#ifndef RXTASK_H
#define	RXTASK_H

#include "output.h"

#ifdef	__cplusplus
extern "C" {
#endif

    extern uint16_t channelCenters[MAX_CHANNELS];
    void rxTask(void *pvParameters);


#ifdef	__cplusplus
}
#endif

#endif	/* RXTASK_H */
