bemcgarvey/RX12G/firmware/src/statusLedTask.h

/////////////////////////////////////////////////////
// Project: RX12G                                  //
// File: statusLedTask.h                           //
// Target: PIC32MK1024GPK064                       // 
// Compiler: XC32                                  //
// Author: Brad McGarvey                           //
// License: GNU General Public License v3.0        //
// Description: status and mode led control        //
/////////////////////////////////////////////////////

#ifndef STATUSLEDTASK_H
#define	STATUSLEDTASK_H

#ifdef	__cplusplus
extern "C" {
#endif

void statusLedTask(void *pvParameters);

#ifdef	__cplusplus
}
#endif

#endif	/* STATUSLEDTASK_H */
