bemcgarvey/RX12G/bootloader/firmware/src/config/default/peripheral/gpio/plib_gpio.h

/*******************************************************************************
  GPIO PLIB

  Company:
    Microchip Technology Inc.

  File Name:
    plib_gpio.h

  Summary:
    GPIO PLIB Header File

  Description:
    This library provides an interface to control and interact with Parallel
    Input/Output controller (GPIO) module.

*******************************************************************************/

/*******************************************************************************
* Copyright (C) 2019 Microchip Technology Inc. and its subsidiaries.
*
* Subject to your compliance with these terms, you may use Microchip software
* and any derivatives exclusively with Microchip products. It is your
* responsibility to comply with third party license terms applicable to your
* use of third party software (including open source software) that may
* accompany Microchip software.
*
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
* IN NO EVENT WILL MICROCHIP BE LIABLE FOR ANY INDIRECT, SPECIAL, PUNITIVE,
* INCIDENTAL OR CONSEQUENTIAL LOSS, DAMAGE, COST OR EXPENSE OF ANY KIND
* WHATSOEVER RELATED TO THE SOFTWARE, HOWEVER CAUSED, EVEN IF MICROCHIP HAS
* BEEN ADVISED OF THE POSSIBILITY OR THE DAMAGES ARE FORESEEABLE. TO THE
* FULLEST EXTENT ALLOWED BY LAW, MICROCHIP'S TOTAL LIABILITY ON ALL CLAIMS IN
* ANY WAY RELATED TO THIS SOFTWARE WILL NOT EXCEED THE AMOUNT OF FEES, IF ANY,
* THAT YOU HAVE PAID DIRECTLY TO MICROCHIP FOR THIS SOFTWARE.
*******************************************************************************/

#ifndef PLIB_GPIO_H
#define PLIB_GPIO_H

#include <device.h>
#include <stdint.h>
#include <stdbool.h>
#include <stddef.h>

// DOM-IGNORE-BEGIN
#ifdef __cplusplus  // Provide C++ Compatibility

    extern "C" {

#endif
// DOM-IGNORE-END

// *****************************************************************************
// *****************************************************************************
// Section: Data types and constants
// *****************************************************************************
// *****************************************************************************


/*** Macros for LEDC pin ***/
#define LEDC_Set()               (LATASET = (1<<12))
#define LEDC_Clear()             (LATACLR = (1<<12))
#define LEDC_Toggle()            (LATAINV= (1<<12))
#define LEDC_OutputEnable()      (TRISACLR = (1<<12))
#define LEDC_InputEnable()       (TRISASET = (1<<12))
#define LEDC_Get()               ((PORTA >> 12) & 0x1)
#define LEDC_PIN                  GPIO_PIN_RA12

/*** Macros for LEDD pin ***/
#define LEDD_Set()               (LATASET = (1<<1))
#define LEDD_Clear()             (LATACLR = (1<<1))
#define LEDD_Toggle()            (LATAINV= (1<<1))
#define LEDD_OutputEnable()      (TRISACLR = (1<<1))
#define LEDD_InputEnable()       (TRISASET = (1<<1))
#define LEDD_Get()               ((PORTA >> 1) & 0x1)
#define LEDD_PIN                  GPIO_PIN_RA1

/*** Macros for BUTTON pin ***/
#define BUTTON_Set()               (LATBSET = (1<<1))
#define BUTTON_Clear()             (LATBCLR = (1<<1))
#define BUTTON_Toggle()            (LATBINV= (1<<1))
#define BUTTON_OutputEnable()      (TRISBCLR = (1<<1))
#define BUTTON_InputEnable()       (TRISBSET = (1<<1))
#define BUTTON_Get()               ((PORTB >> 1) & 0x1)
#define BUTTON_PIN                  GPIO_PIN_RB1

/*** Macros for LEDA pin ***/
#define LEDA_Set()               (LATCSET = (1<<0))
#define LEDA_Clear()             (LATCCLR = (1<<0))
#define LEDA_Toggle()            (LATCINV= (1<<0))
#define LEDA_OutputEnable()      (TRISCCLR = (1<<0))
#define LEDA_InputEnable()       (TRISCSET = (1<<0))
#define LEDA_Get()               ((PORTC >> 0) & 0x1)
#define LEDA_PIN                  GPIO_PIN_RC0

/*** Macros for LEDB pin ***/
#define LEDB_Set()               (LATCSET = (1<<1))
#define LEDB_Clear()             (LATCCLR = (1<<1))
#define LEDB_Toggle()            (LATCINV= (1<<1))
#define LEDB_OutputEnable()      (TRISCCLR = (1<<1))
#define LEDB_InputEnable()       (TRISCSET = (1<<1))
#define LEDB_Get()               ((PORTC >> 1) & 0x1)
#define LEDB_PIN                  GPIO_PIN_RC1

/*** Macros for LEDE pin ***/
#define LEDE_Set()               (LATBSET = (1<<7))
#define LEDE_Clear()             (LATBCLR = (1<<7))
#define LEDE_Toggle()            (LATBINV= (1<<7))
#define LEDE_OutputEnable()      (TRISBCLR = (1<<7))
#define LEDE_InputEnable()       (TRISBSET = (1<<7))
#define LEDE_Get()               ((PORTB >> 7) & 0x1)
#define LEDE_PIN                  GPIO_PIN_RB7


// *****************************************************************************
/* GPIO Port

  Summary:
    Identifies the available GPIO Ports.

  Description:
    This enumeration identifies the available GPIO Ports.

  Remarks:
    The caller should not rely on the specific numbers assigned to any of
    these values as they may change from one processor to the next.

    Not all ports are available on all devices.  Refer to the specific
    device data sheet to determine which ports are supported.
*/

typedef enum
{
    GPIO_PORT_A = 0,
    GPIO_PORT_B = 1,
    GPIO_PORT_C = 2,
    GPIO_PORT_D = 3,
    GPIO_PORT_E = 4,
    GPIO_PORT_F = 5,
    GPIO_PORT_G = 6,
} GPIO_PORT;

typedef enum
{
    GPIO_INTERRUPT_ON_MISMATCH,
    GPIO_INTERRUPT_ON_RISING_EDGE,
    GPIO_INTERRUPT_ON_FALLING_EDGE,
    GPIO_INTERRUPT_ON_BOTH_EDGES,
}GPIO_INTERRUPT_STYLE;

// *****************************************************************************
/* GPIO Port Pins

  Summary:
    Identifies the available GPIO port pins.

  Description:
    This enumeration identifies the available GPIO port pins.

  Remarks:
    The caller should not rely on the specific numbers assigned to any of
    these values as they may change from one processor to the next.

    Not all pins are available on all devices.  Refer to the specific
    device data sheet to determine which pins are supported.
*/

typedef enum
{
    GPIO_PIN_RA0 = 0,
    GPIO_PIN_RA1 = 1,
    GPIO_PIN_RA4 = 4,
    GPIO_PIN_RA7 = 7,
    GPIO_PIN_RA8 = 8,
    GPIO_PIN_RA10 = 10,
    GPIO_PIN_RA11 = 11,
    GPIO_PIN_RA12 = 12,
    GPIO_PIN_RB0 = 16,
    GPIO_PIN_RB1 = 17,
    GPIO_PIN_RB2 = 18,
    GPIO_PIN_RB3 = 19,
    GPIO_PIN_RB4 = 20,
    GPIO_PIN_RB5 = 21,
    GPIO_PIN_RB6 = 22,
    GPIO_PIN_RB7 = 23,
    GPIO_PIN_RB8 = 24,
    GPIO_PIN_RB9 = 25,
    GPIO_PIN_RB10 = 26,
    GPIO_PIN_RB11 = 27,
    GPIO_PIN_RB12 = 28,
    GPIO_PIN_RB13 = 29,
    GPIO_PIN_RB14 = 30,
    GPIO_PIN_RB15 = 31,
    GPIO_PIN_RC0 = 32,
    GPIO_PIN_RC1 = 33,
    GPIO_PIN_RC2 = 34,
    GPIO_PIN_RC6 = 38,
    GPIO_PIN_RC7 = 39,
    GPIO_PIN_RC8 = 40,
    GPIO_PIN_RC9 = 41,
    GPIO_PIN_RC10 = 42,
    GPIO_PIN_RC11 = 43,
    GPIO_PIN_RC12 = 44,
    GPIO_PIN_RC13 = 45,
    GPIO_PIN_RC15 = 47,
    GPIO_PIN_RD5 = 53,
    GPIO_PIN_RD6 = 54,
    GPIO_PIN_RD8 = 56,
    GPIO_PIN_RE12 = 76,
    GPIO_PIN_RE13 = 77,
    GPIO_PIN_RE14 = 78,
    GPIO_PIN_RE15 = 79,
    GPIO_PIN_RF0 = 80,
    GPIO_PIN_RF1 = 81,
    GPIO_PIN_RG6 = 102,
    GPIO_PIN_RG7 = 103,
    GPIO_PIN_RG8 = 104,
    GPIO_PIN_RG9 = 105,

    /* This element should not be used in any of the GPIO APIs.
       It will be used by other modules or application to denote that none of the GPIO Pin is used */
    GPIO_PIN_NONE = -1

} GPIO_PIN;


void GPIO_Initialize(void);

// *****************************************************************************
// *****************************************************************************
// Section: GPIO Functions which operates on multiple pins of a port
// *****************************************************************************
// *****************************************************************************

uint32_t GPIO_PortRead(GPIO_PORT port);

void GPIO_PortWrite(GPIO_PORT port, uint32_t mask, uint32_t value);

uint32_t GPIO_PortLatchRead ( GPIO_PORT port );

void GPIO_PortSet(GPIO_PORT port, uint32_t mask);

void GPIO_PortClear(GPIO_PORT port, uint32_t mask);

void GPIO_PortToggle(GPIO_PORT port, uint32_t mask);

void GPIO_PortInputEnable(GPIO_PORT port, uint32_t mask);

void GPIO_PortOutputEnable(GPIO_PORT port, uint32_t mask);

// *****************************************************************************
// *****************************************************************************
// Section: GPIO Functions which operates on one pin at a time
// *****************************************************************************
// *****************************************************************************

static inline void GPIO_PinWrite(GPIO_PIN pin, bool value)
{
    GPIO_PortWrite((GPIO_PORT)(pin>>4), (uint32_t)(0x1) << (pin & 0xF), (uint32_t)(value) << (pin & 0xF));
}

static inline bool GPIO_PinRead(GPIO_PIN pin)
{
    return (bool)(((GPIO_PortRead((GPIO_PORT)(pin>>4))) >> (pin & 0xF)) & 0x1);
}

static inline bool GPIO_PinLatchRead(GPIO_PIN pin)
{
    return (bool)((GPIO_PortLatchRead((GPIO_PORT)(pin>>4)) >> (pin & 0xF)) & 0x1);
}

static inline void GPIO_PinToggle(GPIO_PIN pin)
{
    GPIO_PortToggle((GPIO_PORT)(pin>>4), 0x1 << (pin & 0xF));
}

static inline void GPIO_PinSet(GPIO_PIN pin)
{
    GPIO_PortSet((GPIO_PORT)(pin>>4), 0x1 << (pin & 0xF));
}

static inline void GPIO_PinClear(GPIO_PIN pin)
{
    GPIO_PortClear((GPIO_PORT)(pin>>4), 0x1 << (pin & 0xF));
}

static inline void GPIO_PinInputEnable(GPIO_PIN pin)
{
    GPIO_PortInputEnable((GPIO_PORT)(pin>>4), 0x1 << (pin & 0xF));
}

static inline void GPIO_PinOutputEnable(GPIO_PIN pin)
{
    GPIO_PortOutputEnable((GPIO_PORT)(pin>>4), 0x1 << (pin & 0xF));
}


// DOM-IGNORE-BEGIN
#ifdef __cplusplus  // Provide C++ Compatibility

    }

#endif
// DOM-IGNORE-END
#endif // PLIB_GPIO_H
