bemcgarvey/RX12G/(commit log)

2022-04-25 Created KiCad project
    [RX12G.kicad_pcb, RX12G.kicad_sch]
2022-04-27 Partial schematic
    [RX12G.kicad_sch, connectors.kicad_sch, power.kicad_sch]
2022-04-29 Harmony project created - pin assignment only
2022-04-29 Complete schematic
    [RX12G.kicad_sch, connectors.kicad_sch, power.kicad_sch]
2022-04-29 Initial pcb with design rules
    [RX12G.kicad_pcb]
2022-04-29 Initial pcb layout - footprints only
    [RX12G.kicad_pcb, connectors.kicad_sch]
2022-04-29 Workable pcb layout
    Needs work on silkscreen
    [RX12G.kicad_pcb, RX12G.kicad_sch]
2022-04-29 Improved board ouline
    [RX12G.kicad_pcb]
2022-04-29 Generated BOM, added gerber settings
    [RX12G.kicad_pcb, RX12G.xlsx]
2022-04-30 Fixed missing SAT_POWER connection
    Also re-assigned some pins to improve pcb layout
    [RX12G.kicad_pcb, RX12G.kicad_sch]
2022-04-30 Rounded outline corners at usb connector
    [RX12G.kicad_pcb]
2022-04-30 Repositioned some components
    Moved sat leds, hid the connector labels
    [RX12G.kicad_pcb]
2022-05-01 Minor fixes.
    D6 footprint, updated BOM
    [RX12G.kicad_pcb, RX12G.kicad_sch, RX12G.xlsx, power.kicad_sch]
2022-05-01 Some minor silkscreen fixes
    [RX12G.kicad_pcb]
2022-05-01 Changed R3 value and some minor track adjustments
    [RX12G.kicad_pcb, RX12G.kicad_sch, power.kicad_sch]
2022-05-02 Generated gerbers
    [RX12G-B_Cu.gbl, RX12G-B_Mask.gbs, RX12G-B_Silkscreen.gbo, RX12G-Edge_Cuts.gm1, RX12G-F_Cu.gtl, RX12G-F_Mask.gts, RX12G-F_Silkscreen.gto, RX12G-NPTH-drl_map.gbr]
2022-05-19 With I2C test code
2022-05-19 With RTOS
    [configuration.h]
2022-05-19 Sat power tested
2022-05-20 Clean start - system timer running
2022-05-21 UART DMA working
2022-05-21 Improved DMA
2022-05-22 PWM outputs working
2022-05-22 Bind button task working
2022-05-23 Passthrough mode working
    Still needs failsafe detection.
    [gyroTask.c, gyroTask.h, main.c, output.c, output.h, rtosHandles.h, rxTask.c, satellites.c]
2022-05-24 Normal failsafe working
    Improved channel enable
    [output.c, output.h, satellites.c]
2022-05-24 Added status leds
2022-05-25 Improved led task
2022-05-25 Fixed spurious channel bug
    [main.c, rxTask.c]
2022-05-27 USB enumerates
    [configuration.h]
2022-05-27 Revert "Initial Qt project"
    This reverts commit 72e322c37bd2a0aa7e445bbf03dcde9e7fa22cd5.
    [main.cpp, mainwindow.cpp, mainwindow.h]
2022-05-30 Preset failsafe working
    Fixed bug where failsafe values were being overwritten
    [mainwindow.cpp, mainwindow.h, output.c, settings.c, usbapp.c]
2022-05-30 getChannels timer turned off when on another tab
2022-05-30 IMU communication working
2022-05-30 Reading acceleration correctly
    Fixed bug where ExtInt2 was too high a priority for a FreeRTOS API call
    [RX12G.h, imu.c, imu.h, interrupts.c, mainwindow.cpp, mainwindow.h]
2022-05-31 Gyro and accel working
2022-06-01 Increased usb wait time
    Hopefully prevents occasional save errors
    [HidUSBLink.cpp, HidUSBLink.h, main.c, mainwindow.cpp]
2022-06-01 Added icon and fixed menu issue
    [mainwindow.cpp]
2022-06-02 Fixed bug caused by hidWatcher having a parent
    [QHidWatcher.cpp, QHidWatcher.h]
2022-06-03 Added sensor display UI elements
2022-06-04 Increased freeRTOS heap size and gyroTask stack size
2022-06-04 Added gyro offset calibration and imuReady signal
2022-06-05 Level calibration working
2022-06-06 gyroTask framework in place
2022-06-07 Improved sensor display
2022-06-08 Changed servo update method
    Only update servo positions after positions have been sent to outputs.
2022-06-10 Mapped axes correctly. Fusion working well.
    [gyroTask.c, imu.c, mainwindow.cpp, mainwindow2.cpp, qhorizonwidget.cpp]
2022-06-11 Improved gyro calibration
2022-06-12 Added aileron/elevator wiggle when imu ready
    Also fixed the output limit checks
    Put calibration time back to 2 sec.
    [gyroTask.c, imu.h]
2022-06-13 Added bootloader
    [configuration.h]
2022-06-13 Finalized pmd and handled imu failure modes
    [gyroTask.c, imu.c, imu.h, main.c, statusLedTask.c, tasks.c]
2022-06-13 Changed upper channel offsets to allow for 200Hz rate
2022-06-16 Revert "Changed upper channel offsets to allow for 200Hz rate"
    This reverts commit d4eb5f1dcffb48557b9e3866d52f74f4f5c5acf6.
    [gyroTask.c, output.c]
2022-06-16 Revert "Finalized pmd and handled imu failure modes"
    This reverts commit 8459ccad66629b4c4f65116186b16cd6f5d56a7b.
    [gyroTask.c, imu.c, imu.h, main.c, statusLedTask.c, tasks.c]
2022-06-16 Reversed pitch adjustment when inverted.
    Removed timing code from updateAttitude. It was overriding the zSign value.
    [attitude.c, autolevel.c, gyroTask.c]
2022-06-16 Handled some imu failure modes
    [gyroTask.c, imu.c, imu.h, main.c, tasks.c]
2022-06-17 Fixed level correction for different orientations
    [mainwindow2.cpp]
2022-06-22 Added elevon settings plus some minor fixes and clean up
    [RX12G.h, main.c, mainwindow.cpp, mainwindow.h, mainwindow2.cpp, rxTask.c, satellites.h, settings.h]
2022-06-25 Added stubs for trainer and attitude lock
    Also added custom modes and some minor fixes
    [attitudeLock.c, attitudeLock.h, gyroTask.c, launchAssist.c, trainer.c, trainer.h]
2022-06-25 Changed bootloader folder to keep MHC happy and some minor tweaks
    Turned on all LEDs in bootload mode.
    Added a 2 second delay on the button
    [configuration.h]
2022-06-25 Added ypr display to sensor tab
2022-06-28 Added watchdog timer
2022-07-02 Added adjustment to pitch correction based on roll
    [autolevel.c, launchAssist.c]
2022-07-04 Fixed button bounce problem and WDT when entering bind mode.
    [buttonTask.c]
2022-07-05 Fixed some errors in pitch code
    [normalMode.c]
2022-09-11 Added rxOnly mode
    Also fixed offsets on upper channels to allow up to 200Hz servo rate.
    [RX12G.h, main.c, mainwindow.cpp, mainwindow.h, mainwindow2.cpp, output.c, rtosHandles.h, rxOnlyTask.c]
2022-09-15 Changed USB detection method
    Now will detect USB plugged in at any time, not just at power on.
2022-09-15 Fixed reboot bug
    Servos were going out of range sometimes. Added a process to shut off outputs before restart.
    [main.c, mainwindow.cpp, output.c, output.h, tasks.h, usbapp.c]
2022-09-16 Fixed pitch autolevel bug
    [autolevel.c, launchAssist.c]
2022-09-17 Improved output timing
    Also added key to prevent accidental output disable
    [gyroTask.c, gyroTask.h, output.c, output.h, usbapp.c]
2022-09-19 Implemented TAER/AETR channel ordering
    AETR still needs to be tested.
    Fixed error in attitudeLock.c where AILERON was used instead of RUDDER.
    Fixed wiggle timing to use control loop freq
    [attitudeLock.c, gyroTask.c, launchAssist.c, main.c, normalMode.c, output.c, output.h, sbus.c]
2022-09-27 Fixed yaw gain channel bug
    [gyroTask.c]
2022-09-30 Fixed XPlus channels bug
    [rxTask.c]
2022-09-30 Fixed phase bit handling
    [rxTask.c]
2022-10-11 Improved output setting.
    Also fixed an elevator2 bug and limits tab in UI
    [gyroTask.c, mainwindow.cpp]
2022-10-22 Fixed bug when a gyro axis is reversed
    [angleMode.c, trainer.c]
2022-10-30 Fixed baud rate. Changed satellite detection for SBus
    Still a bug with SAT3
    [satellites.c, uart.c]
2022-10-30 Fixed UART error interrupt bug
    [interrupts.c, satellites.c, sbus.c]
2022-10-31 SBus satellites are now detected correctly
    [satellites.c]
2022-10-31 Added missing file comment headers
    [angleMode.c, angleMode.h, attitude.c, attitude.h, attitudeLock.c, attitudeLock.h, autoLevel.h, autolevel.c]
2022-11-01 Added nmi handler to bootloader to handle clock failure
    [main.c, version.h]
2022-11-01 Fixed missing lines in gyro display bars and min-max bars
    [gyrodisplay.cpp, minmaxbar.cpp]
2022-11-25 Added some default PID values
2023-08-30 Improved imu initialization
    Moved init function to task
2024-01-03 Fixed bug in bindSats function
    [satellites.c, version.h]
2025-07-01 Update to KiCad 9.0
    [RX12G.kicad_sch, connectors.kicad_sch, power.kicad_sch]
2025-07-03 Update pcb to KiCad 9
    [RX12G.kicad_pcb]
